SeoKeon/Robot-Control-Lab/README.md

# Robot Control Lab 🤖

> 펌웨어 엔지니어의 제어 실험 기록.
> 모터 관절 하나 → FOC 직접 구현 → 2축 로봇팔 + 보행 시뮬레이션.

실험 하나 끝날 때마다 [log/](log/)에 글 하나. 코드와 데이터는 [projects/](projects/)에.
실패한 튜닝, 태워먹은 부품까지 전부 기록한다.

## 타임라인

<!-- 최신이 위. 글을 올릴 때마다 여기에 한 줄 추가 -->

### 2026-10

- **10-10** 위치 루프 — 전류·속도·위치 캐스케이드 완성. +450도 갔다 돌아와도 0.2도 이내, 손으로 42도 밀었다 놓아도 0.4초에 복귀. 궤적 + 피드포워드, 정지 직전 끈적임(stick-slip) 관찰 ([log](log/2026-10-10-position-loop.md))
- **10-10** 속도 루프 — p1 완료 🎉 눌러도 150 rpm 을 지키고, 꽉 잡으면 iq 150 mA 한계에서 버티다 놓으면 0.2초에 복귀. J·Kt 로 게인 계산, 대역폭 5→15 Hz 로 한 바퀴 출렁임 sd 52 → 5 rpm. 블로킹 로그가 루프를 멈추던 결함도 발견 ([log](log/2026-10-10-speed-loop.md))
- **10-10** 전류 루프 — FOC 완성 🎉 꽉 잡아도 iq 가 지령 100.0 mA 에 고정 (전압 모드는 159 mA). 피드포워드 + 적분기 ([log](log/2026-10-10-current-loop-foc.md))
- **10-10** dq 전류 관측 — 정지 시 id≈0·iq 159mA 로 변환 검증, 회전 시 id 는 각도 지연 탓. AS5600 필터 + 각도 외삽 보정으로 무부하 id 45 → 2~4 mA ([log](log/2026-10-10-dq-observation-and-encoder-lag.md))
- **10-10** 전류 센싱 브링업 — 내장 OPAMP ×16 + ADC, 꼭대기 샘플링 정렬. 정지 벡터에서 +234/−103/−132 mA, 세 상 합 ≈ 0 ([log](log/2026-10-10-current-sense-bringup.md))
- **10-10** 첫 클로즈드루프 🎉 — 오프셋 캘리브레이션(−72.5°, 2회 차이 0.0°) + 엔코더 기반 정류. 정/역 255/−251 rpm, 잡았다 놓아도 0.5초 안에 복귀(탈조 없음) ([log](log/2026-10-10-first-closed-loop-commutation.md))
- **10-10** 지그 장착 + 엔코더 검증 — 드리프트 −44° → ±1°, 2회 재현, 회전 중 AGC 고정(PWM 간섭 없음) ([log](log/2026-10-10-jig-and-encoder-validation.md))

### 2026-08

- **08-29** AS5600 엔코더 브링업 — I2C 검증, 자석 부재→장착, 드리프트 원인 판별 실험 설계 ([log](log/2026-08-29-encoder-bringup.md))
- **08-27** 모터 첫 회전 🎉 — 오픈루프 왕복 스윕, 5단계 속도 추종·탈조 없음 (전류 0.2A 미만) ([log](log/2026-08-27-first-motor-rotation.md))
- **08-27** p0 완료 — 시리얼 "hello" 뚫기. UM2516 에서 핀맵 확정, USART2(PB3/PB4) VCP 확인 ([log](log/2026-08-27-p0-complete-uart-hello.md))
- **08-19** 보드 공용 계층 분리 — 실험마다 복제되던 HAL/CMSIS 를 platform/g431-esc1 한 벌로, 빌드 경로 정리 ([log](log/2026-08-19-platform-layer-and-build-setup.md))
- **08-05** B-G431B-ESC1 개발환경 세팅 — CubeCLT + VS Code로 빌드·플래싱·디버깅 완주 ([log](log/2026-08-05-dev-environment-setup.md))
- **08-01** 도착 부품 테스트 — 전원공급장치 C.V/C.C/OCP, 멀티미터 전류 측정에서 단락 ([log](log/2026-08-01-parts-testing.md))

### 2026-07

- **07-22** 프로젝트 시작 — 레포 개설, 목표 선언 ([log](log/2026-07-22-kickoff.md))

## 레포 구조

```
platform/g431-esc1/   보드 공용 계층 — 실험마다 동일한 것은 전부 여기 한 벌만
├── g431-esc1.ioc         CubeMX 프로젝트 (보드 단위 하나)
├── Core/, Drivers/       CubeMX 생성물 (HAL·CMSIS 포함)
├── bsp/                  손으로 쓴 보드 공용 코드 (핀 래퍼 등)
├── platform.cmake        프로젝트가 부르는 add_lab_firmware()
└── template/             새 실험 시작용 복사본

hardware/             기구 공용 계층 — 실험이 같이 쓰는 거치대·지그 (CadQuery 원본 + 출력 3MF)
└── foc-test-stand/       모터 + AS5600 + ESC1 테스트 거치대

projects/pN-이름/      실험 하나 = 폴더 하나
├── src/                  실험 코드 + 짧은 CMakeLists (platform 참조)
├── data/                 측정 데이터 (선별해서 커밋)
└── docs/                 회로도, 배선 사진 등

log/                  실험 하나 = 글 하나
notes/                이론 학습 노트
```

보드는 항상 B-G431B-ESC1 하나다. 그래서 HAL·CMSIS·startup·링커스크립트는
실험마다 복사하지 않고 `platform/g431-esc1` 한 벌을 공유한다.
새 실험은 `platform/g431-esc1/template/` 를 복사해서 시작한다 —
CubeMX를 새로 돌리지 않는다.

## 기록 규칙

1. **단위**: 실험(또는 공부 주제) 하나 = 글 하나. 몰아서 쓰지 않는다.
2. **위치와 이름**: `log/YYYY-MM-DD-제목.md` (예: `log/2026-08-02-closed-loop-position.md`).
   이미지·그래프는 `log/img/`에 넣고 글에서 상대경로로 링크.
3. **형식**: [log/_template.md](log/_template.md) 복사해서 시작.
   "뭘 하려고 했나 → 뭘 했나 → 막힌 것과 해결 → 배운 것" 순서. 막힌 과정이 본편.
4. **타임라인 갱신**: 글을 올리면 이 README 타임라인에 한 줄 추가 (최신이 위).
5. **코드·데이터**: `projects/` 아래 해당 프로젝트 폴더에 커밋하고 글에서 링크.
   데이터는 선별해서 커밋 (원시 로그 전체 X, 그래프 재현에 필요한 것만).
   보드 공용 코드는 `projects/` 가 아니라 `platform/g431-esc1/bsp/` 로 간다.
6. **실패도 기록**: 안 된 튜닝, 태워먹은 부품, 잘못 짚은 원인 전부.
   포트폴리오는 성공담이 아니라 문제 해결 서사다.
7. **커밋 메시지**: `log: 2026-08-02 클로즈드루프 위치 제어` / `p1: 엔코더 캘리브레이션 코드` 식으로
   접두어(log/p1/p2/…/notes/platform)를 붙인다.
8. **"되게 했다"에서 멈추지 않는다**: 왜 되는지 설명이 붙어야 글 완성.

## 장비 (계속 추가)

<!-- 새 장비 들어올 때마다 한 줄 추가 -->

| 장비 | 용도 | 추가 |
|---|---|---|
| B-G431B-ESC1 | 모터 드라이버 보드 (STM32G431, 3션트 전류 센싱) | 2026-07 |
| 짐벌모터 2804 (AS5600 내장) | 실험용 관절 | 2026-07 |
