SeoKeon/Robot-Control-Lab/notes/2026-07-22-pid-cascade-structure.md

# 2026-07-22 PID 캐스케이드 구조 — 전류→속도→위치

<!-- 예시 노트. 실습에서 막힌 지점을 이론에서 찾아올 때 이 형식으로 -->

## 왜 찾아봤나

SimpleFOC 설정에 전류/속도/위치 루프가 따로 있는 이유가 궁금해서.

## 핵심

- 모터 제어는 루프 3개가 겹겹이 싸인 구조: 가장 안쪽 **전류(=토크)** → **속도** → 가장 바깥 **위치**
- 안쪽 루프일수록 빨라야 한다 (전류 10~20kHz, 속도 ~1kHz, 위치 수백 Hz).
  바깥 루프 입장에서 안쪽 루프는 "즉시 반응하는 액추에이터"로 보여야 하기 때문
- **내부 루프 대역폭이 외부 루프 성능의 상한을 정한다** — 전류 루프가 느리면
  위치 게인을 아무리 올려도 소용없고 오히려 발진

## 실습 연결

- P1에서 클로즈드루프 전환 시 루프별 튜닝 순서: 안쪽부터 (전류 → 속도 → 위치)
- P3에서 사인 스윕으로 루프별 대역폭 실측해 이 관계 확인 예정

## 출처

- Brian Douglas, "Understanding PID Control" 시리즈
- SimpleFOC docs — motion control 페이지
