SeoKeon/Robot-Control-Lab/log/2026-07-22-kickoff.md

# 2026-07-22 프로젝트 시작 — 레포 개설, 목표 선언

## 뭘 하려고 했나

제어이론을 코어 역량으로 만들기 위한 실험 기록 레포 개설.
모터 관절 하나에서 시작해 FOC 직접 구현 → 2축 로봇팔 → 보행 시뮬레이션까지 간다.

## 뭘 했나

- GitHub 레포 생성, 폴더 구조·기록 규칙 확정
- 첫 실험 대상 확정: B-G431B-ESC1 + 짐벌모터 2804(AS5600)
- 다음 단계: 환경 구축 (마운트 고정, 배선, 개발환경, Blink + 시리얼 확인)

## 막힌 것과 해결 과정

없음 (셋업 단계)

## 배운 것 / 다음 할 것

- [ ] 어댑터 → XT30 변환 케이블 납땜
- [ ] 모터 마운트 고정 + 배선
- [ ] PlatformIO 설치, G431 인식 확인
