SeoKeon/Robot-Control-Lab/files/asm.png

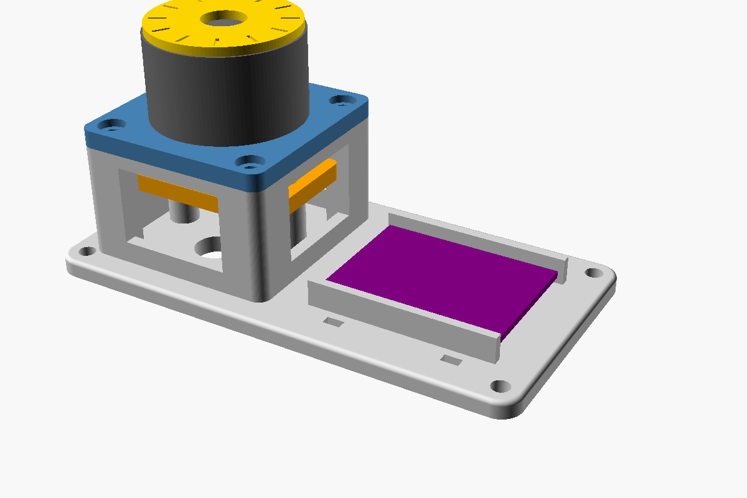
files/asm.png
