SeoKeon/Robot-Control-Lab/log/2026-08-01-parts-testing.md

# 2026-08-01 도착 부품 테스트 — 전원공급장치와 멀티미터

## 뭘 하려고 했나

도착한 부품이 정상인지 확인하고, 앞으로 계속 쓸 전원공급장치와 멀티미터의
사용법을 익히는 것. 모터를 물리기 전에 계측 장비부터 손에 익혀두려고 했다.

## 뭘 했나

1. 브레드보드에 전원공급장치 5V 2A 세팅
2. 집에 있는 간단한 쿨러를 연결하여 동작 확인 함
3. 5V → 7V로 올려서 회전수가 빨라지는지 확인
4. 멀티미터로 확인했을 때 최대측정 0.2A, 200mA로 설정했을 때 40mA 측정 됨.
   5V, 7V 모두 비슷하게 나왔음
5. 전압 출력은 **병렬**로 회로와 회로 끝을 확인하여 전원공급장치가 정상적으로
   전압을 주는 것을 확인
6. 전류는 위(4.)에 설명대로 **직렬**로 연결 후 측정 진행함

## 막힌 것과 해결 과정

### 저항 없는 회로에 멀티미터 전류를 물려 단락

이번 테스트 진행 중 실수로 저항이 없는 회로에 멀티미터 전류를 측정 했음.
이때 전류 한계는 0.2A로 지정. 저항이 없으므로 전류가 폭주하여 OCP 경고가 뜨며
전원공급장치에서 볼테이지 에러가 뜨며 전압공급이 중단 됨.

왜 이렇게 되는지가 핵심이었다.

- 멀티미터의 **전압** 측정은 내부저항이 매우 높아 멀티미터쪽으로 오는 전류가 최소화 됨.
  따라서 기존 회로에 영향을 최대한 주지 않을수록 좋은 멀티미터라고 함
- 멀티미터의 **전류** 측정의 경우 회로에 영향을 최대한 안 끼치기 위해 저항이 0임.
  `I = V/R` 이기 때문에 저항이 없는 회로를 측정하면 전류가 확 튈 수 있음

즉 전류 모드 멀티미터를 저항 없는 경로에 물리는 것은 그 자체가 단락이다.
이때 전원공급장치의 전류 공급 한계(limit)를 걸어놔야 그나마 안전함.

**해결/대처**: 전류 리밋이 0.2A로 걸려 있어서 OCP가 동작해 전압이 차단됐다.
리밋을 걸어두지 않았다면 부품이나 멀티미터 퓨즈가 갔을 상황.

## 배운 것 / 다음 할 것

### 전원공급장치의 세 가지 상태

전원 공급장치에는 C.V, C.C, OCP 라는 용어가 있었음.

이름 그대로 **무엇을 일정하게 유지하는가**가 차이다.

| 용어 | 뜻 |
|---|---|
| **C.V** (Constant Voltage) | 확인해보니 **전압을 일정하게 유지**하는 것을 의미함. 회로가 요구하는 전류가 리밋 안쪽일 때의 정상 상태 |
| **C.C** (Constant Current) | 확인해보니 **전류를 일정하게 유지**하는 것을 의미함. 저항이 너무 낮아서 전류가 확 튈 때 **전압을 그만큼 낮추어 전류를 고정**해줄 수 있다는 장점이 있음. 이를 활용하여 어디서 회로가 잘못됐는지 디버깅하는 데에 활용할 수 있음 |
| **OCP** (Over Current Protection) | 전류 한계보다 더 높은 전류를 요구하게 되었을 때 **전압을 차단**함 |

> 이해가 두 번 바뀐 항목이다.
> C.C 를 처음엔 "보낼 수 있는 전류 한계에 도달한 **상태**"로만 이해했는데,
> 다시 확인해보니 전압을 낮춰 전류 리밋을 유지하는 **기능**이었고,
> 한 번 더 확인해보니 결국 **전류를 일정하게 유지하는 것**이 본질이었다.
> (Gemini 설명: 전원을 끄지 않고 전압을 0V 근처로 떨어뜨리면서 안전한 전류만 계속 흘려준다)

### 단락을 찾을 때는 OCP 보다 C.C

AI한테 물어보니 실제 회로 단락 문제를 찾을 때는 OCP를 켜놓는 것 보단
**C.C 한계를 활용**하여 찾는게 더 수월하다고 함.
이유는 전원이 바로 차단되어버리면 디버깅이 어렵기 때문이라고 함.

C.C 로 두면 전류가 안전한 값으로 계속 흐르는 상태가 유지되므로,
그 상태에서 어디가 뜨거워지는지 / 어느 지점에서 전압이 떨어지는지를 짚어갈 수 있다.

### 다음

- 멀티미터 전류 모드는 **직렬 + 부하 있는 경로에만**. 물리기 전에 리밋 먼저 확인
- 모터를 물릴 때는 기동 전류(정지 상태에서 확 튀는 전류)를 감안해 리밋을 잡아야 함
