SeoKeon/Robot-Control-Lab/files/assembly.step

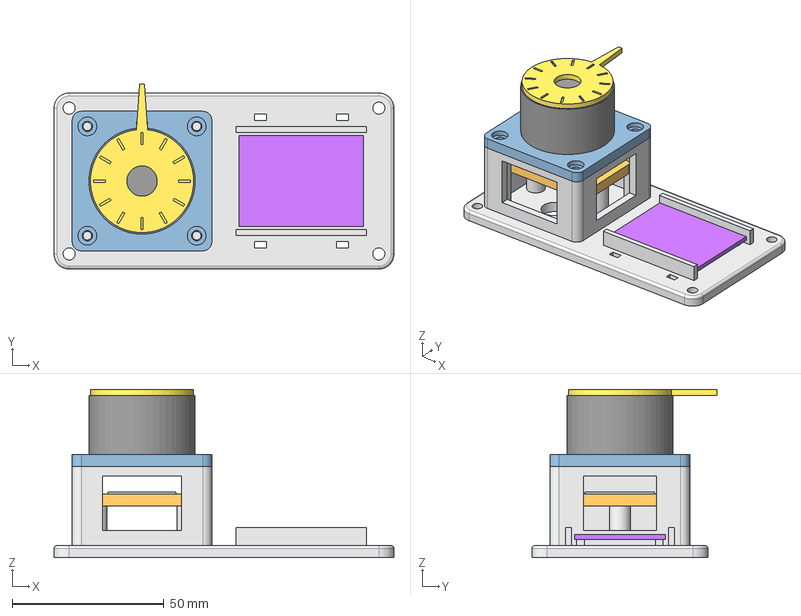
[picture p2: CAD file, 2026-10-10]
files/assembly.step
112.0 x 61.0 x 55.5 mm
base
motor_plate
sensor_carrier
as5600_dummy
motor_dummy
indicator
esc1_dummy
