SeoKeon/Robot-Control-Lab/files/out/assembly.step

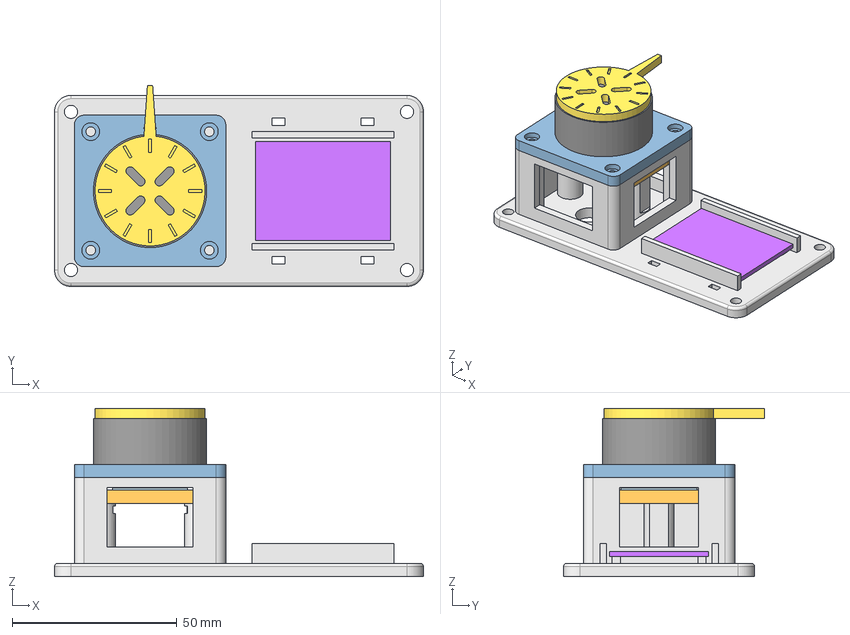
[picture p3: CAD file, 2026-10-10]
files/out/assembly.step
112.0 x 61.0 x 51.0 mm
base
motor_plate
sensor_carrier
as5600_dummy
motor_dummy
indicator
magnet_plug
esc1_dummy
