SeoKeon/Robot-Control-Lab/files/foc_test_stand_A1mini_v4.3mf

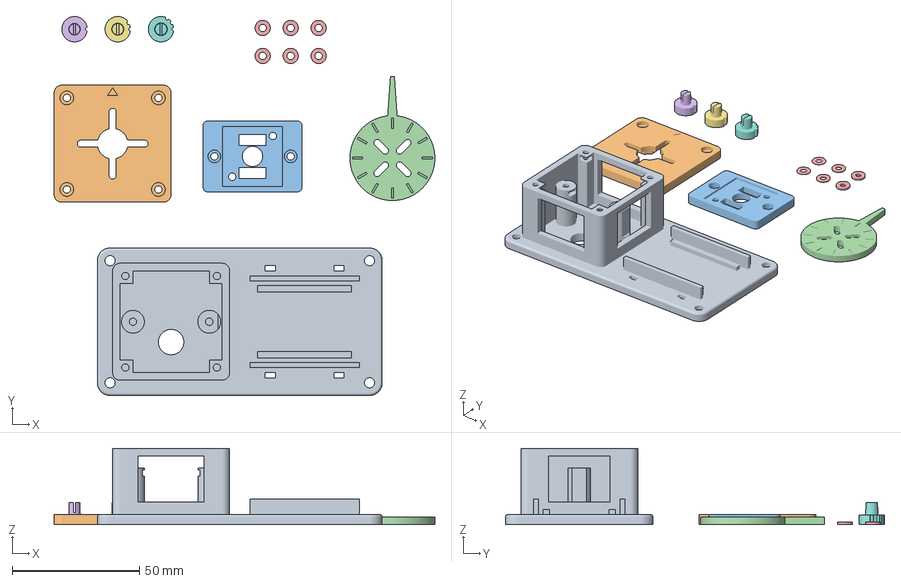
[picture p4: CAD file, 2026-10-10]
files/foc_test_stand_A1mini_v4.3mf
149.7 x 149.0 x 30.0 mm
base
motor_plate
sensor_carrier
indicator
spacers
magnet_plug_m4_4.5
magnet_plug_m4_4.7
magnet_plug_m4_4.9
