SeoKeon/Robot-Control-Lab/files/out/magnet_plug_m4_4.9.step

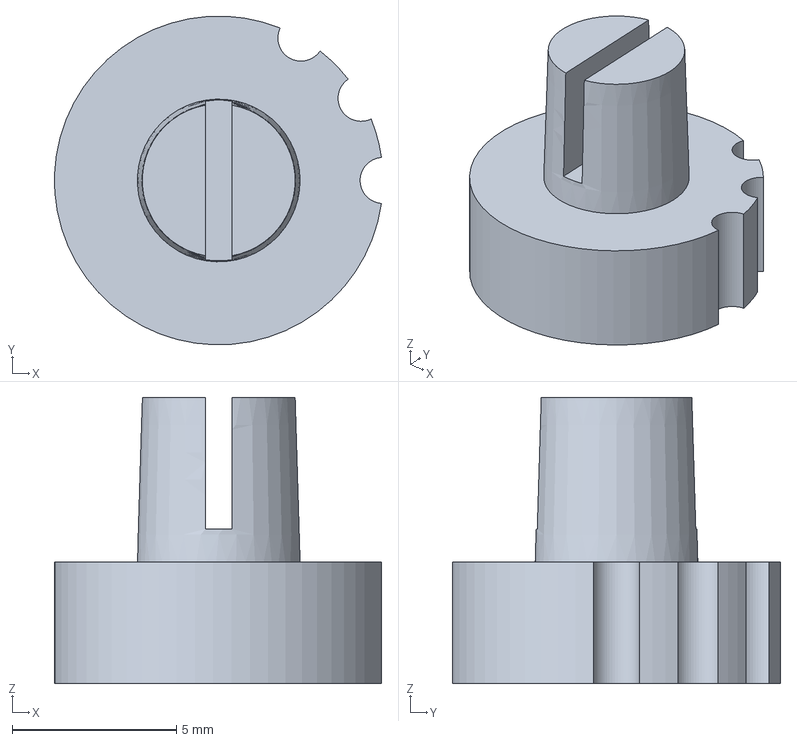
[picture p5: CAD file, 2026-10-10]
files/out/magnet_plug_m4_4.9.step
9.95 x 9.99 x 8.70 mm
