SeoKeon/Robot-Control-Lab/hardware/foc-test-stand/print/foc_test_stand_A1mini_v4_표시판.3mf

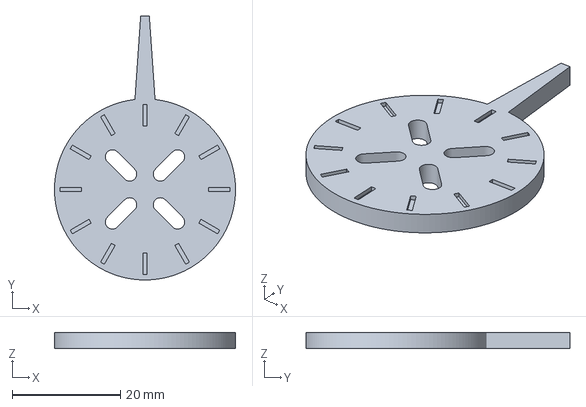
[picture p6: CAD file, 2026-10-10]
hardware/foc-test-stand/print/foc_test_stand_A1mini_v4_표시판.3mf
33.4 x 48.7 x 3.00 mm
