SeoKeon/Robot-Control-Lab/files/foc_test_stand_A1mini_v4_자석플러그.3mf

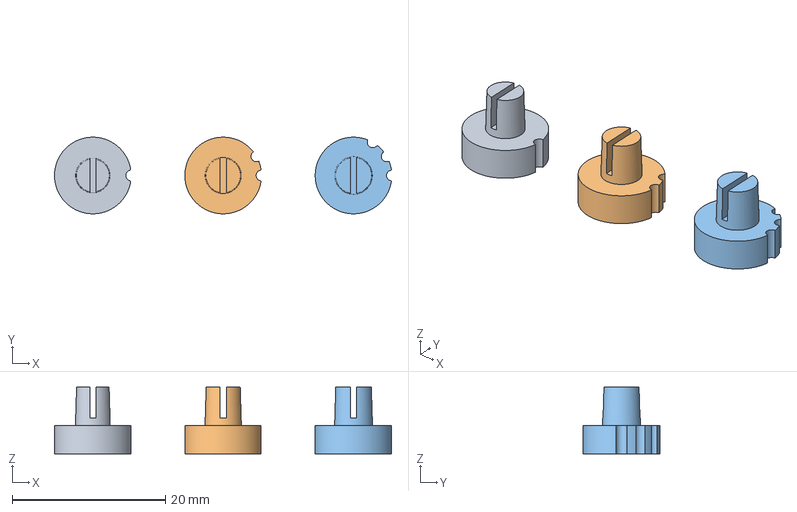
[picture p8: CAD file, 2026-10-10]
files/foc_test_stand_A1mini_v4_자석플러그.3mf
43.9 x 10.00 x 8.70 mm
magnet_plug_m4_4.5
magnet_plug_m4_4.7
magnet_plug_m4_4.9
