SeoKeon/Robot-Control-Lab/files/out/base.step

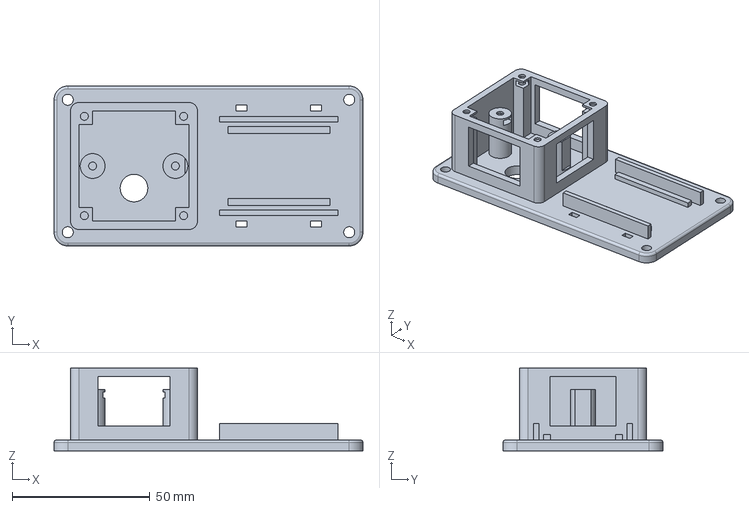
[picture p9: CAD file, 2026-10-10]
files/out/base.step
112.0 x 58.0 x 30.0 mm
