SeoKeon/Robot-Control-Lab/files/out/magnet_plug_m6_4.7.step

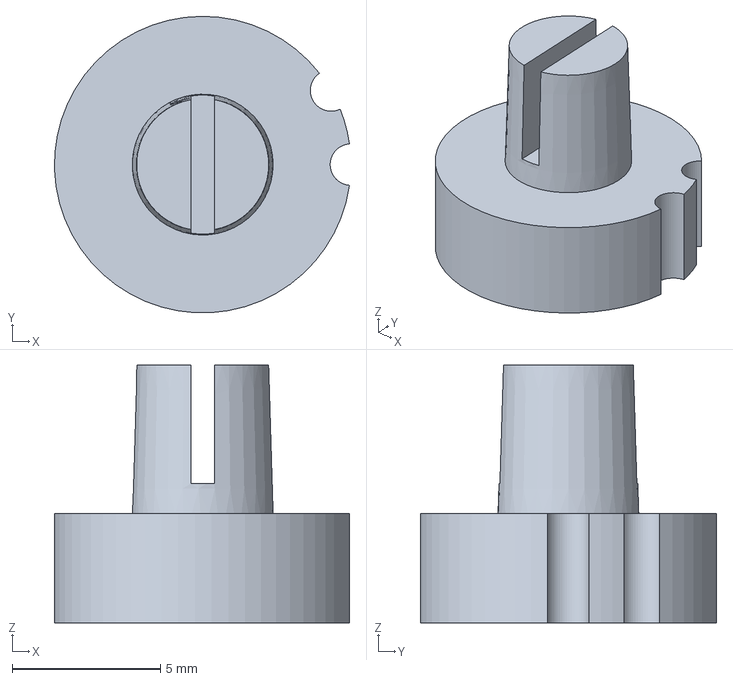
[picture p10: CAD file, 2026-10-10]
files/out/magnet_plug_m6_4.7.step
9.95 x 9.99 x 8.70 mm
