SeoKeon/Robot-Control-Lab/files/out/magnet_plug_m4_4.5.step

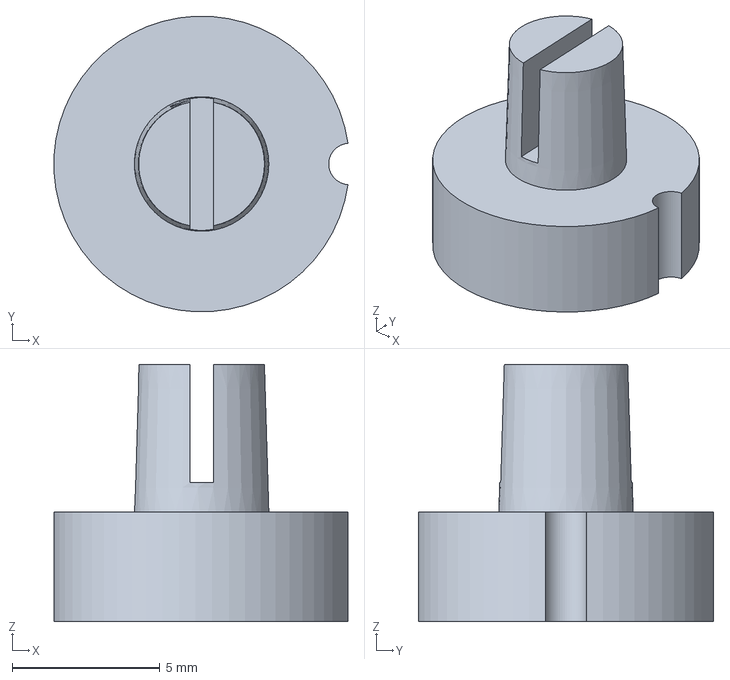
[picture p11: CAD file, 2026-10-10]
files/out/magnet_plug_m4_4.5.step
9.94 x 9.99 x 8.70 mm
