SeoKeon/Robot-Control-Lab/files/out/spacers.step

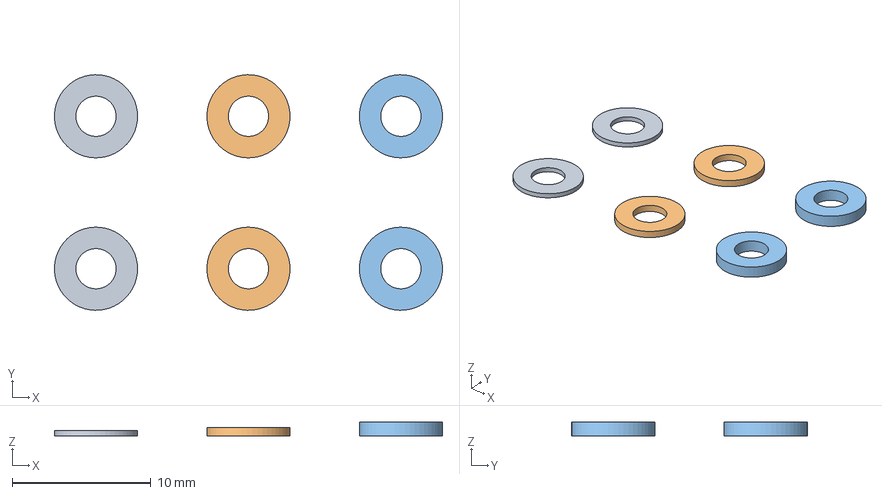
[picture p12: CAD file, 2026-10-10]
files/out/spacers.step
28.0 x 17.0 x 1.00 mm
