SeoKeon/Robot-Control-Lab/files/out/sensor_carrier.step

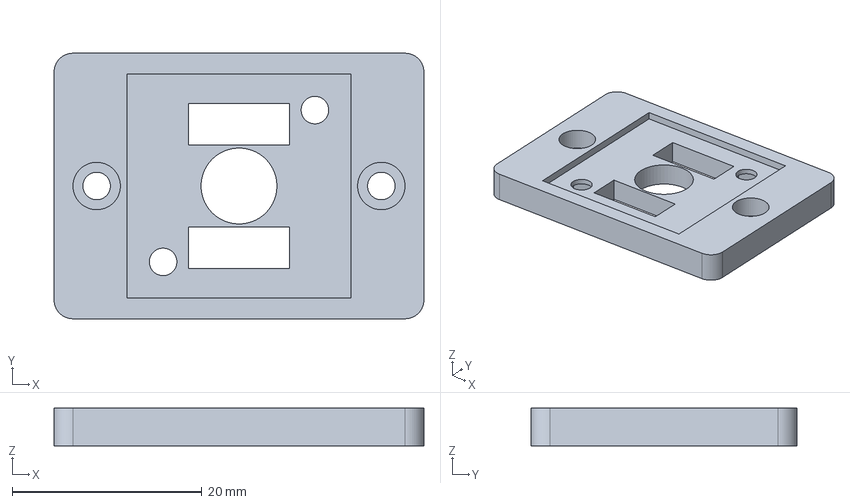
[picture p13: CAD file, 2026-10-10]
files/out/sensor_carrier.step
39.0 x 28.0 x 4.00 mm
