SeoKeon/Robot-Control-Lab/files/out/motor_plate.step

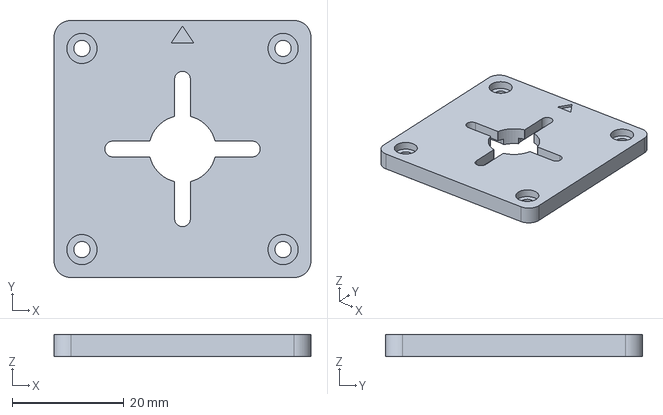
[picture p14: CAD file, 2026-10-10]
files/out/motor_plate.step
46.0 x 46.0 x 4.00 mm
