SeoKeon/Robot-Control-Lab/files/old/foc_test_stand_A1mini_v2.3mf

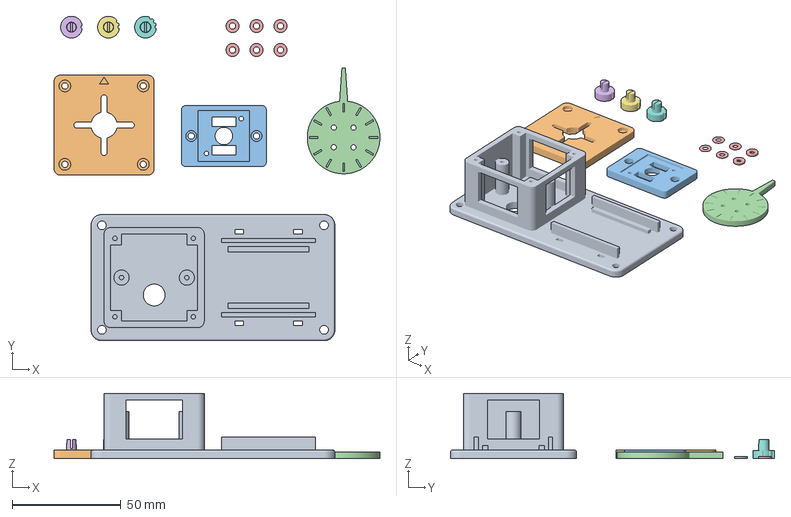
[picture p15: CAD file, 2026-10-10, an earlier design]
files/old/foc_test_stand_A1mini_v2.3mf
149.7 x 149.0 x 30.0 mm
base
motor_plate
sensor_carrier
indicator
spacers
magnet_plug_4.5
magnet_plug_4.7
magnet_plug_4.9
