SeoKeon/Robot-Control-Lab/(list of files, cad)

Other CAD files:
files/out/indicator.step
files/out/magnet_plug_m6_4.5.step
files/out/magnet_plug_m4_4.7.step
files/old/foc_test_stand_A1mini_v3.3mf
files/old/foc_test_stand_A1mini.3mf
files/old/foc_test_stand_A1mini_v3_재출력.3mf
files/out/base.stl
files/out/indicator.stl
files/out/magnet_plug_m4_4.5.stl
files/out/magnet_plug_m4_4.7.stl
files/out/magnet_plug_m4_4.9.stl
files/out/magnet_plug_m6_4.5.stl
files/out/magnet_plug_m6_4.7.stl
files/out/magnet_plug_m6_4.9.stl
files/out/motor_plate.stl
files/out/sensor_carrier.stl
files/out/spacers.stl
