SeoKeon/Robot-Control-Lab/projects/p1-foc-bringup/README.md

# p1-foc-bringup — 모터 첫 회전과 FOC

**목표**: 2804 짐벌모터를 실제로 돌린다. 오픈루프 첫 회전 → 전류 센싱 →
클로즈드루프 FOC. 완료 기준은 **전류 루프가 닫힌 상태로 속도 지령을 따라가는 것**.

- `src/foc_bringup/` — 실험 코드
- `data/` — 측정 데이터 (전류 파형, 속도 응답 등)
- `docs/` — (핀맵은 [p0-setup/docs/pinmap.md](../p0-setup/docs/pinmap.md) 에 있다)

## 모터

| | |
|---|---|
| 모델 | 2804 짐벌모터 (AS5600 내장) |
| 슬롯/극 | 12N14P → **pole pairs = 7** |
| 전기각 | θe = 7 × θm. 전기 360° = 기계 51.43° |
| 상간 저항 | **21Ω** 실측 (U-V, V-W, W-U 동일) → Y결선 상저항 10.5Ω |
| 스펙 상저항 | 11.2Ω — 실측 10.5Ω 과 일치 (제조사 스펙 교차 검증) |
| 외형/무게 | Ø34 × 15mm, 41.5g. 최대 14.8V / 5A / 약 2180rpm |
| **장착 나사 (실측)** | **베이스 4×M2.5** (홀 원 지름 약 19.8 mm, 깊이 4 mm 이상), **로터 4×M2** (배치 원 약 12.8 mm). 웹 스펙(베이스 M2)과 달랐다 — "2804" 는 제조사마다 다르니 실측이 정본 |
| 중공축 | 내경 4.7 mm (실측, 축과 함께 회전), 바닥 돌출 0, 모터 높이 14 mm |
| 코깅 주기 | LCM(12,14) = 84 → 4.29° |

이론 정리는 [2026-08-20 로그](../../log/2026-08-20-motor-anatomy-and-board-bringup.md) 참고.

첫 회전 기록: [2026-08-27 로그](../../log/2026-08-27-first-motor-rotation.md) · 이론: [상보 PWM/데드타임](../../notes/2026-08-27-tim1-complementary-pwm-deadtime.md), [오픈루프와 FOC](../../notes/2026-08-27-openloop-vector-and-why-foc.md)

## 안전 — 매번 확인

| 항목 | 값 | 왜 |
|---|---|---|
| 전원 전류 리밋 | **0.8~1A** | 정상 최대 0.57A(12V/21Ω)보다 위, 션트-스루보다 훨씬 아래 |
| 시작 듀티 | **20~30%** | 10%는 토크가 약해 안 움직일 수 있다 |
| 부하 | 없음 | 무부하, 모터 고정만 |
| 정지 벡터 유지 | 1~2초 | DC 가 권선에 계속 흘러 열이 쌓인다 |

⚠️ **TIM1_BKIN 이 MCU 에 연결돼 있지 않다.** 하드웨어 과전류 차단 경로가 없으므로
**전원공급장치의 전류 리밋이 유일한 실질 보호장치다.**

⚠️ **게이트 드라이버 EN 핀이 없다.** 6개 PWM 만으로 제어되므로 소프트웨어로 출력을
끊는 수단이 없다. 리셋 직후 MOE off / 듀티 0 으로 시작할 것.

## TIM1 설정값 (계산 완료)

| 항목 | 값 | 근거 |
|---|---|---|
| U상 | `CH1` PA8 / `CH1N` PC13 | UM2516 Table 4 |
| V상 | `CH2` PA9 / `CH2N` PA12 | |
| W상 | `CH3` PA10 / `CH3N` PB15 | |
| 카운터 모드 | Center-aligned | FOC 표준. 전류 샘플링 타이밍이 여기 걸린다 |
| Prescaler | 0 | |
| ARR | **4249** | 170MHz ÷ (2 × 4250) = **20 kHz** (가청 주파수 위) |
| **데드타임 (DTG)** | **149** (0x95) | **= 1000 ns.** 아래 유도 참고 |

### 데드타임 유도

L6387E 데이터시트 Table 5 (AC operation, VCC=15V, TJ=25°C, 전부 Typ. 값):

| 파라미터 | 값 |
|---|---|
| `ton` 턴온 전파지연 | 110 ns |
| `toff` 턴오프 전파지연 | 105 ns |
| `tr` 상승시간 (CL=1nF) | 50 ns |
| `tf` 하강시간 | 30 ns |
| 출력 sink/source 전류 | 400 mA / 650 mA |

Figure 6/7 (Ton/Toff vs 온도) 축이 250 ns 까지 그려져 있다 — 온도에 따라 typ 보다 커진다.

**상단이 완전히 꺼진 뒤에 하단이 켜져야 한다:**

```
DT_min ≳ (toff_최대 + MOSFET 게이트 방전) − ton_최소
       ≈ (약 200 + 약 250) − 약 70
       ≈ 380 ns
```

MOSFET 게이트 방전은 STL180N6F7 의 Qg 를 driver sink 전류(400 mA)로 나눈 추정치다
(정확한 값은 STL180N6F7 데이터시트 필요).

**첫 브링업은 ×2 여유를 두고 1000 ns 로 잡는다.** 근거:
- `TIM1_BKIN` 이 MCU 에 연결돼 있지 않아 **하드웨어 과전류 차단이 없다** → 보수적으로
- 20 kHz 주기 50 µs 중 1 µs = **2%** 뿐이라 변조 성능 손실이 사실상 없다

### GPIO 출력 속도는 Low 로 (6개 전부)

`PC13` 은 CubeMX 에서 **`Low` 밖에 선택할 수 없다.** PC13/14/15 는 백업 도메인
(RTC/TAMP/WKUP) 쪽 핀이라 구동 능력이 제한된다. 버그가 아니다.

**문제되지 않는다.** 회로도에서 확인한 `L6387ED` 결선:

```
L6387ED (상마다 하나 — U9/U10/U11)
  1 LIN  ← MCU 연결 (로직 입력, 수 pF CMOS)
  2 HIN  ← MCU 연결
  5 LVG  → MOSFET 게이트 (드라이버가 sink 400mA / source 650mA 로 구동)
  7 HVG  → MOSFET 게이트
```

MCU 는 MOSFET 게이트가 아니라 **드라이버의 로직 입력**만 흔든다. 부하가 수 pF 이므로
Low 속도로도 에지는 수 ns 다. 데드타임 예산은 드라이버 전파지연(105/110 ns)과
MOSFET 게이트 충·방전이 지배하고, MCU 슬루율은 그 안에서 무시할 수준이다.

→ **6개 핀 전부 Low 로 통일한다.** 절대 속도보다 **채널 간 편차(skew)** 가
중요하고, PC13 이 Low 고정이니 나머지도 맞추면 U/V/W 가 동일 조건이 된다.

> PC13 은 `TIM1_BKIN` 도 지원하는 핀이지만 여기선 CH1N 으로 쓴다.
> 어차피 보드에 BKIN 배선이 없어 무관하다.

### DTG 레지스터 환산 (RM0440, TIM1 BDTR)

TIM1 clk 170 MHz, CKD=1 → `t_DTS` = **5.882 ns**

| DTG[7:5] | 식 | 범위 |
|---|---|---|
| `0xx` | DT = DTG[7:0] × t_DTS | 0 ~ 747 ns |
| `100` | DT = (64 + DTG[5:0]) × 2 × t_DTS | 753 ~ 1118 ns |

1000 ns 는 첫 범위를 넘으므로 `100` 인코딩을 쓴다:

```
(64 + 21) × 2 × 5.882 ns = 85 × 11.765 = 1000.0 ns
DTG = 0b100_10101 = 0x95 = 149
```

> 대안: `DTG = 127` (0x7F) → 747 ns. 최소값(380 ns)의 약 2배로 이것도 방어 가능하다.
> 스코프로 상·하단 게이트 파형을 실측한 뒤 줄이는 게 정석이다.

## 진행 단계

- [x] TIM1 상보 PWM 6채널 + 데드타임 (2026-08-27)
- [x] (a) 정지 벡터 — 12스텝 추종 확인. m=0.30 은 토크 부족(94도 기대에 70도),
      PWM off 시 코깅 디텐트(4.29도)로 안착하는 것도 관찰
- [x] (b)(c) 왕복 스윕 — **모터 선이 함께 도는 구조라 기계각 180도 제한** →
      연속 회전 대신 ±50도 왕복으로 변경. m=0.45, 5단계 속도 전부 추종,
      전류 0.2A 미만, 탈조 없음. **오픈루프 한계는 기계 457deg/s(76rpm) 이상**
- [x] ADC + 내장 OPAMP 3션트 전류 센싱 (2026-10-10) — PGA ×16, 꼭대기 샘플링, 1 count ≈ 29.4 mA.
      정지 벡터에서 세 상 패턴·부호·합≈0 확인. [로그](../../log/2026-10-10-current-sense-bringup.md)
- [x] Clarke/Park dq 관측 (2026-10-10) — 정지 시 id≈0, iq 159mA. 회전 시 id 는 각도 지연 탓,
      AS5600 필터 SF=2x 로 1.68→0.85ms. [로그](../../log/2026-10-10-dq-observation-and-encoder-lag.md)
- [x] 각도 외삽(θ + ω·τ) — τ 스윕으로 id=0 지점 0.87ms 확인, τ=0.85ms 고정. 무부하 id 45 → 2~4 mA
- [x] 전류 루프 (2026-10-10) — 피드포워드(R·iq + ψ·ω) + 적분기. 정지 시 iq 100.0 mA = 지령, id 0.0.
      [로그](../../log/2026-10-10-current-loop-foc.md)
- [x] d축 우선 전압 제한 (2026-10-10) — 계단 직후 포화(최대 10%) 중에도 id ±1 mA
- [x] 속도 루프 (2026-10-10) ← **p1 완료 기준 달성**. 속도 PI → iq 지령(±150 mA), 게인은
      J·Kt 에서 계산, 대역폭 15 Hz. 평균 오차 0.1 rpm 이내, 꽉 잡으면 iq 150.0 mA 한계 고정,
      놓으면 0.2 s 복귀. [로그](../../log/2026-10-10-speed-loop.md)
- [x] UART 비동기 송신 — 블로킹 로그가 100 ms 마다 루프를 6 ms 멈추던 결함 수정
- [x] 위치 루프 (2026-10-10, 완료 기준 너머) — 위치 P(4 Hz) + 사다리꼴 궤적 + 속도·가속 피드포워드.
      +450도 갔다 복귀해도 0.2도 이내, 밀면 iq 한계까지 버티고 놓으면 0.3~0.4 s 에 ±2도.
      정지 직전 stick-slip 관찰. [로그](../../log/2026-10-10-position-loop.md)
- [x] AS5600 엔코더 (2026-10-10) — 지그(접착 자석 플러그 + 스페이서 1mm)로 MD=1 / AGC=21.
      오픈루프 통합 실험 2회: 부호판정 50.2/50.3도(기대 51.4), 최종 오차 −1.1/+0.7도,
      회전 중 AGC 24 고정(간섭 없음). 08-29 드리프트(−44/−21.6도) 해소.
      [로그](../../log/2026-10-10-jig-and-encoder-validation.md) · 원본 데이터는 `data/`
- [x] 전기각 오프셋 캘리브레이션 → 엔코더 기반 정류 = 전압 모드 FOC (2026-10-10).
      오프셋 −72.5도(2회 차이 0.0), 정/역 255/−251 rpm, 브레이크 후 0.5초 내 복귀,
      전류 0.13A(회전)→0.16A(부하). [로그](../../log/2026-10-10-first-closed-loop-commutation.md)

## 빌드

```powershell
cd src\foc_bringup
cmake --preset Debug
cmake --build --preset Debug
```
