SeoKeon/Robot-Control-Lab/log/2026-08-20-motor-anatomy-and-board-bringup.md

# 2026-08-20 실습 준비 및 간단한 이론공부 진행

## 뭘 하려고 했나

- 모터를 보드에 연결하여 직접 돌려보려고 했으나, 필요물품이 부족한것을 알고 저항측정 및 준비만 추가로 진행

## 뭘 했나
- 엔코더에 선 연결용 납땜이 되지않아 이 부분 진행
- XT30 사용방법 숙지
- g431-esc1 보드 +- 확인방법 숙지
- 2804 짐벌모터 저항 UVW 측정 아무곳이나 찍었을때
12 : 21옴
13 : 21옴
23 : 21옴

## 막힌 것과 해결 과정
- 330°C인데 납이 패드에 안 붙고 인두팁에만 붙음
  → 팁 산화 / 팁에서 납을 먼저 녹인 순서 / 플럭스 부족
  → 팁 청소 후 즉시 코팅, 패드를 먼저 데우고 납은 패드 쪽에 댈 것
- 케이블이 아두이노 점퍼선(AWG24~28)뿐 → 내열·강도 부족, AWG20 실리콘 와이어 주문

## 배운 것 / 다음 할 것
- g431 보드에 5핀 커넥터의 테두리와 전압 공급용 부위는 같은 그라운드이므로 납땜전 햇갈릴때 확인 가능
- XT30 연결 및 바나나커넥터 납땜 후 전압 공급기에 연결하여 g431 보드에 전원인가
- g431보드 UVW 3상을 2804모터에 연결 및 납땜
- 저항측정을 기반으로 흘려야하는 전류를 확인하여 초기 전압 확인 및 모터 회전 확인
- XT30: 전원 나오는 쪽(케이블)=암, 받는 쪽(보드)=수

## 이해한 것
- 전기각 = 자속 파형의 위상. θe = 7 × θm
- 자석 N-S 한 쌍 = 자속 루프 하나 = 전기각 360° = 기계각 51.43°
- 12N14P: 이빨 2개씩 6그룹, 한 상이 4코일. 쌍 안에서 권선 방향 반전(210°→30°)
- 각 상 유효축이 전기각 120° 간격 → 합성 벡터 1.5I가 회전
- SimpleFOC pole_pairs에는 7을 넣을 것 (14 아님)

## 간단한 이론 공부 (공부 후 Claude 요약)
1. 모터의 물리 구조
스테이터 — 규소강판을 겹친 철심. 안쪽(아웃러너는 바깥쪽)으로 돌기가 나 있고 이게 이빨(tooth). 이빨에 코일을 감고, 이빨 사이 골이 슬롯. 이빨과 슬롯은 개수가 같다.
로터 — 영구자석이 원주를 따라 N, S 교대로 붙어 있음. 자석 하나가 1극(Pole), N-S 한 쌍이 1극쌍(Pole pair).
12N14P 표기 — N은 슬롯 수, P는 극 수. 2804는 슬롯 12, 자석 14 = 7극쌍.

2. 극의 방향
자석은 반경 방향으로 자화되어 있다. 자석 하나의 N과 S는 안쪽 면과 바깥쪽 면으로 마주본다.
원주를 따라 보이는 N, S, N, S는 서로 다른 자석의 안쪽 면이다. 하나 걸러 뒤집어 붙였을 뿐.
자속은 이웃한 N과 S를 잇는 폐루프를 그린다 — 180° 맞은편이 아니라 바로 옆으로 돌아온다. 이 루프 하나가 자기 회로의 최소 반복 단위.

3. 전기각 = 자속 파형의 위상
스테이터에 고정된 한 점에서 자속을 측정하면, 로터 1회전당 사인파 7주기가 지나간다. 자석 14개가 차례로 지나가니까.
전기각은 이 파형의 위상이고, **한 주기 = 360°**로 정의한다.
θe = 극쌍수 × θm = 7 × θm
전기각 360°  ↔  기계각 51.43°
"전기 한 바퀴 = 자석 한 쌍"은 정의가 아니라 결과. 자석 한 쌍만큼 이동하면 자기 상태가 완전히 동일해지고(모터는 그 이동을 구분 못 한다), 그게 한 주기의 정의니까.
감속기 비유로는 전기각이 입력축, 기계각이 7:1 출력축. 단 각도 환산 관계로만 유효하다.

4. 12N14P 권선 배치
이빨 12개가 인접 2개씩 6그룹. 한 상이 마주보는 두 그룹, 즉 코일 4개를 가져간다.
1  2   3  4   5  6   7  8   9 10  11 12
U  U   V  V   W  W   U' U'  V' V'  W' W'
왜 인접 쌍인가 — 이빨 간격 30° × 7 = 전기각 210°. 3상에 안 맞는다. 한쪽 코일을 거꾸로 감으면 210 − 180 = **30°**가 되어 두 코일이 합쳐진다.
검증 — 인접 그룹은 이빨 4개(기계각 120°) 간격, ×7 = 840 ≡ 전기각 120°. 3상 성립.
완전히 겹치지 않아 cos(15°)만큼 손해. 최종 권선계수 0.933.
프라임(') — 별개 상이 아니라 같은 상의 반대 극성 절반. 같은 전류가 흐르지만 반대로 감겨 자극이 뒤집힌다.

5. 회전자기장
개별 이빨은 회전하지 않는다. 제자리에서 N ↔ S를 왕복할 뿐. 전광판 글자가 흘러가는 것과 같은 원리로, 패턴이 미끄러지는 것이다.
각 상의 코일 4개를 합치면 하나의 유효 축이 되고, 세 축이 전기각 120° 간격으로 벌어진다(15°, 135°, 255°).
합성 벡터 = 1.5 × I, 크기 일정, 방향만 회전
어느 한 상이 0을 지나도 나머지 둘이 받쳐줘서 데드 포인트가 없다. 이게 3상을 쓰는 이유.
토크 조건 — 스테이터 자기장이 로터보다 전기각 90° 앞설 때 최대. τ ∝ sin(위상차). 겹치면(d축) 토크 0, 열만 남음. 90°가 q축.

6. 슬롯·극 조합 규칙
성립 조건 — N은 3의 배수, P는 짝수, N과 P가 나누어떨어지면 안 됨.
3N6P가 안 되는 이유: 120° × 3 = 360 ≡ 0°. 세 이빨 위상이 같아져 벡터가 회전하지 못하고 크기만 변한다. 3N2P, 3N4P는 성립.
코깅 — 무전원 상태에서 자석이 철심에 끌리는 힘. 주기는 LCM(슬롯, 극)으로 결정. 12N14P는 LCM(12,14)=84 → **4.29°**로 잘게 쪼개져 아주 부드럽다.
코깅이 크다 ≠ 못 돈다. 두 문제는 별개.
슬롯 늘리기 = 부드러움, 극 늘리기 = 토크, 크기 늘리기 = 진짜 힘. 슬롯을 늘리면 구리 공간이 줄어 오히려 손해일 수 있다.

7. 실습으로 이어지는 것
pole_pairs = 7 (14 아님). 예제 기본값 11을 반드시 바꿀 것
Y결선 → 두 상선 사이 저항은 상저항의 2배. 21Ω 측정 → 상저항 10.5Ω
상선 순서는 무관. 두 가닥 바꾸면 회전 방향만 반대
initFOC()에서 모터가 덜컥 움직이는 것 = d축 전압으로 강제 정렬해 전기각 오프셋을 측정하는 과정. 이때 손으로 잡으면 안 됨
극쌍수 확인법 — 전기각 1회전 시 로터가 51.43° 이동하는지, 또는 상선에 스코프 물리고 손으로 한 바퀴 돌려 사인파 개수 세기
600 rpm → 전기 주파수 70 Hz (×7)
