SeoKeon/Robot-Control-Lab/hardware/foc-test-stand/img/asm_v2_section.png

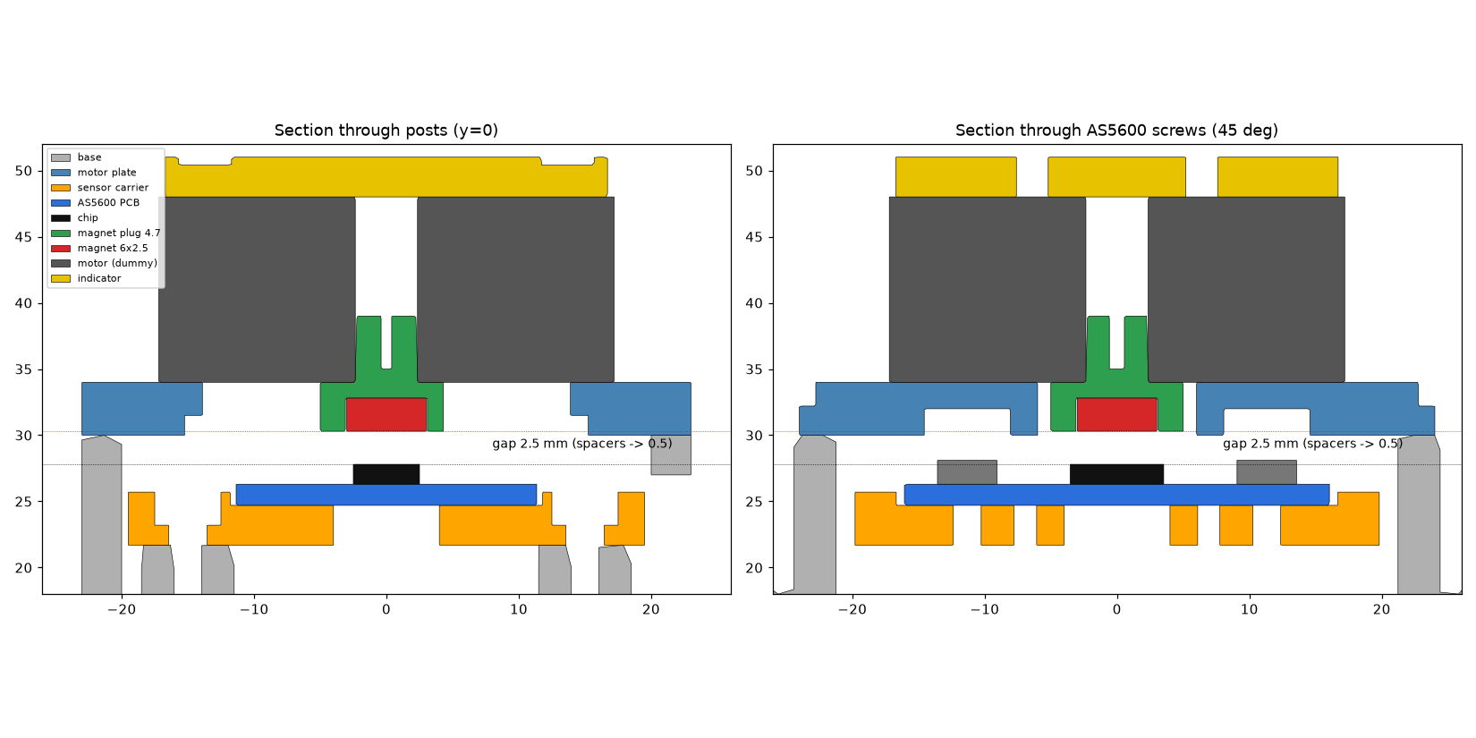
hardware/foc-test-stand/img/asm_v2_section.png
