SeoKeon/Robot-Control-Lab/platform/g431-esc1/g431-esc1.ioc

Mcu.UserName=STM32G431CBUx
PA1.Signal=OPAMP1_VINP
PA10.Signal=S_TIM1_CH3
PA12.Signal=TIM1_CH2N
PA13.Signal=SYS_JTMS-SWDIO
PA14.Signal=SYS_JTCK-SWCLK
PA3.Signal=OPAMP1_VINM0
PA5.Signal=OPAMP2_VINM0
PA7.Signal=OPAMP2_VINP
PA8.Signal=S_TIM1_CH1
PA9.Signal=S_TIM1_CH2
PB0.Signal=OPAMP3_VINP
PB15.Signal=TIM1_CH3N
PB2.Signal=OPAMP3_VINM0
PB3.Signal=USART2_TX
PB4.Signal=USART2_RX
PB7.Signal=I2C1_SDA
PB8-BOOT0.Signal=I2C1_SCL
PC13.Signal=TIM1_CH1N
PC6.GPIO_Label=LD2
PC6.Signal=GPIO_Output
