SeoKeon/Robot-Control-Lab/platform/g431-esc1/bsp/Src/bsp.c

#include "bsp.h"

#include <stdarg.h>
#include <stdio.h>
#include <string.h>
#include <math.h>

/* CubeMX 가 Core/Src/main.c 에 만든 핸들. MX_USART2_UART_Init() 이
   app_main() 보다 먼저 불리므로 여기서 바로 써도 된다. */
extern UART_HandleTypeDef huart2;

#define BSP_UART          (&huart2)
#define BSP_UART_TIMEOUT  100u   /* ms. 블로킹 송신이라 무한대기는 피한다 */

#define TXQ_SIZE 2048u   /* 2의 거듭제곱 */
static uint8_t           txq[TXQ_SIZE];
static volatile uint16_t txq_head, txq_tail;   /* head = 넣는 쪽(메인), tail = 빼는 쪽(인터럽트) */
static volatile int      txq_async;
static uint32_t          txq_dropped;

void USART2_IRQHandler(void)
{
    USART_TypeDef *u = BSP_UART->Instance;
    if ((u->CR1 & USART_CR1_TXEIE_TXFNFIE) && (u->ISR & USART_ISR_TXE_TXFNF)) {
        if (txq_tail != txq_head) {
            u->TDR = txq[txq_tail];
            txq_tail = (uint16_t)((txq_tail + 1u) & (TXQ_SIZE - 1u));
        } else {
            u->CR1 &= ~USART_CR1_TXEIE_TXFNFIE;
        }
    }
}

uint32_t bsp_uart_set_async(int on)
{
    if (on) {
        HAL_NVIC_SetPriority(USART2_IRQn, 3, 0);
        HAL_NVIC_EnableIRQ(USART2_IRQn);
        txq_async = 1;
    } else if (txq_async) {
        uint32_t t0 = HAL_GetTick();
        while (txq_tail != txq_head && HAL_GetTick() - t0 < 2000u) { }
        txq_async = 0;
    }
    return txq_dropped;
}

void bsp_uart_write(const uint8_t *data, uint16_t len)
{
    if (!txq_async) {
        HAL_UART_Transmit(BSP_UART, (uint8_t *)data, len, BSP_UART_TIMEOUT);
        return;
    }
    for (uint16_t i = 0; i < len; i++) {
        uint16_t next = (uint16_t)((txq_head + 1u) & (TXQ_SIZE - 1u));
        if (next == txq_tail) { txq_dropped += (uint32_t)(len - i); break; }
        txq[txq_head] = data[i];
        txq_head = next;
    }
    __disable_irq();
    BSP_UART->Instance->CR1 |= USART_CR1_TXEIE_TXFNFIE;
    __enable_irq();
}

void bsp_uart_puts(const char *s)
{
    bsp_uart_write((const uint8_t *)s, (uint16_t)strlen(s));
}

void bsp_printf(const char *fmt, ...)
{
    char    buf[256];
    va_list ap;

    va_start(ap, fmt);
    int n = vsnprintf(buf, sizeof buf, fmt, ap);
    va_end(ap);

    if (n <= 0) {
        return;
    }
    /* vsnprintf 는 "잘리지 않았다면 필요했을 길이"를 준다 */
    if (n > (int)sizeof buf - 1) {
        n = (int)sizeof buf - 1;
    }
    bsp_uart_write((const uint8_t *)buf, (uint16_t)n);
}

void bsp_led_on(void)     { HAL_GPIO_WritePin(BSP_LED_PORT, BSP_LED_PIN, GPIO_PIN_SET); }
void bsp_led_off(void)    { HAL_GPIO_WritePin(BSP_LED_PORT, BSP_LED_PIN, GPIO_PIN_RESET); }
void bsp_led_toggle(void) { HAL_GPIO_TogglePin(BSP_LED_PORT, BSP_LED_PIN); }

/* ===================== AS5600 (I2C1) ===================== */

extern I2C_HandleTypeDef hi2c1;   /* CubeMX 가 main.c 에 만든 핸들 */

#define AS5600_HAL_ADDR   (BSP_AS5600_ADDR << 1)   /* HAL 은 8비트 주소를 받는다 */
#define AS5600_REG_STATUS 0x0Bu
#define AS5600_REG_RAWANG 0x0Cu                    /* 0x0C(H) 0x0D(L) 빅엔디언 */
#define AS5600_I2C_TO     20u                      /* ms */

void bsp_i2c_scan(void)
{
    int found = 0;

    bsp_uart_puts("I2C1 scan:");
    for (uint8_t a = 0x08; a < 0x78; a++) {
        if (HAL_I2C_IsDeviceReady(&hi2c1, (uint16_t)(a << 1), 1, 5) == HAL_OK) {
            bsp_printf(" 0x%02X", a);
            found++;
        }
    }
    bsp_printf("  (%d개)\r\n", found);
}

int bsp_as5600_magnet_ok(uint8_t *detail)
{
    uint8_t st = 0;

    if (HAL_I2C_Mem_Read(&hi2c1, AS5600_HAL_ADDR, AS5600_REG_STATUS,
                         I2C_MEMADD_SIZE_8BIT, &st, 1, AS5600_I2C_TO) != HAL_OK) {
        if (detail) { *detail = 0; }
        return 0;
    }
    if (detail) { *detail = st; }
    return (st & 0x20u) ? 1 : 0;   /* bit5 MD */
}

int bsp_as5600_read_agc(uint8_t *agc)
{
    /* AGC(0x1A): 자동 게인. 5V 모드 0~255, 3.3V 모드 0~128.
       값이 클수록 자기장이 약하다 = 자석이 멀다. 중간값(약 64)이 이상적. */
    if (HAL_I2C_Mem_Read(&hi2c1, AS5600_HAL_ADDR, 0x1Au,
                         I2C_MEMADD_SIZE_8BIT, agc, 1, AS5600_I2C_TO) != HAL_OK) {
        return -1;
    }
    return 0;
}

int bsp_as5600_set_filter(uint8_t sf, uint8_t fth, uint16_t *conf_out)
{
    /* CONF: 0x07 = [WD | FTH(3) | SF(2)], 0x08 = [PWMF | OUTS | HYST | PM] */
    uint8_t hi = 0;
    if (HAL_I2C_Mem_Read(&hi2c1, AS5600_HAL_ADDR, 0x07u, I2C_MEMADD_SIZE_8BIT,
                         &hi, 1, AS5600_I2C_TO) != HAL_OK) { return -1; }
    hi = (uint8_t)((hi & ~0x1Fu) | ((fth & 0x07u) << 2) | (sf & 0x03u));
    if (HAL_I2C_Mem_Write(&hi2c1, AS5600_HAL_ADDR, 0x07u, I2C_MEMADD_SIZE_8BIT,
                          &hi, 1, AS5600_I2C_TO) != HAL_OK) { return -1; }
    if (conf_out) {
        uint8_t b[2] = {0, 0};
        HAL_I2C_Mem_Read(&hi2c1, AS5600_HAL_ADDR, 0x07u, I2C_MEMADD_SIZE_8BIT, b, 2, AS5600_I2C_TO);
        *conf_out = (uint16_t)(((uint16_t)b[0] << 8) | b[1]);
    }
    return 0;
}

int bsp_as5600_read_raw(uint16_t *raw)
{
    uint8_t b[2];

    if (HAL_I2C_Mem_Read(&hi2c1, AS5600_HAL_ADDR, AS5600_REG_RAWANG,
                         I2C_MEMADD_SIZE_8BIT, b, 2, AS5600_I2C_TO) != HAL_OK) {
        return -1;
    }
    *raw = (uint16_t)(((uint16_t)(b[0] & 0x0Fu) << 8) | b[1]);
    return 0;
}

/* ===================== 3상 PWM (TIM1) ===================== */

extern TIM_HandleTypeDef htim1;   /* CubeMX 가 main.c 에 만든 핸들 */

#define BSP_TIM (&htim1)

static float bsp_clampf(float v, float lo, float hi)
{
    return (v < lo) ? lo : ((v > hi) ? hi : v);
}

void bsp_pwm_start(void)
{
    /* 켜기 전에 듀티 0. 상보 PWM 이므로 이 상태는 하단 3개만 ON = 3상 단락(브레이크).
       회전자가 정지 상태라면 전류가 흐르지 않는다. */
    __HAL_TIM_SET_COMPARE(BSP_TIM, TIM_CHANNEL_1, 0);
    __HAL_TIM_SET_COMPARE(BSP_TIM, TIM_CHANNEL_2, 0);
    __HAL_TIM_SET_COMPARE(BSP_TIM, TIM_CHANNEL_3, 0);

    HAL_TIM_PWM_Start(BSP_TIM, TIM_CHANNEL_1);
    HAL_TIMEx_PWMN_Start(BSP_TIM, TIM_CHANNEL_1);
    HAL_TIM_PWM_Start(BSP_TIM, TIM_CHANNEL_2);
    HAL_TIMEx_PWMN_Start(BSP_TIM, TIM_CHANNEL_2);
    HAL_TIM_PWM_Start(BSP_TIM, TIM_CHANNEL_3);
    HAL_TIMEx_PWMN_Start(BSP_TIM, TIM_CHANNEL_3);
}

void bsp_pwm_stop(void)
{
    HAL_TIM_PWM_Stop(BSP_TIM, TIM_CHANNEL_1);
    HAL_TIMEx_PWMN_Stop(BSP_TIM, TIM_CHANNEL_1);
    HAL_TIM_PWM_Stop(BSP_TIM, TIM_CHANNEL_2);
    HAL_TIMEx_PWMN_Stop(BSP_TIM, TIM_CHANNEL_2);
    HAL_TIM_PWM_Stop(BSP_TIM, TIM_CHANNEL_3);
    HAL_TIMEx_PWMN_Stop(BSP_TIM, TIM_CHANNEL_3);

    /* 확실히 끊는다. OCIdleState=Reset 이므로 6핀 모두 Low = MOSFET 전부 off */
    __HAL_TIM_MOE_DISABLE(BSP_TIM);

    /* HAL 은 채널을 다 끄면 카운터까지 멈춘다. 카운터는 계속 돌려야 전류 센싱 ADC
       트리거가 끊기지 않고 꼭대기 정렬도 유지된다. MOE=0 이라 출력은 전부 off */
    __HAL_TIM_ENABLE(BSP_TIM);
}

void bsp_pwm_set_duty(float du, float dv, float dw)
{
    du = bsp_clampf(du, BSP_PWM_DUTY_MIN, BSP_PWM_DUTY_MAX);
    dv = bsp_clampf(dv, BSP_PWM_DUTY_MIN, BSP_PWM_DUTY_MAX);
    dw = bsp_clampf(dw, BSP_PWM_DUTY_MIN, BSP_PWM_DUTY_MAX);

    __HAL_TIM_SET_COMPARE(BSP_TIM, TIM_CHANNEL_1, (uint32_t)(du * (float)BSP_PWM_ARR));
    __HAL_TIM_SET_COMPARE(BSP_TIM, TIM_CHANNEL_2, (uint32_t)(dv * (float)BSP_PWM_ARR));
    __HAL_TIM_SET_COMPARE(BSP_TIM, TIM_CHANNEL_3, (uint32_t)(dw * (float)BSP_PWM_ARR));
}

void bsp_pwm_set_vector(float theta_e, float m)
{
    static const float k120 = 2.0943951f;   /* 2*pi/3 */

    const float amp = 0.5f * m;
    bsp_pwm_set_duty(0.5f + amp * cosf(theta_e),
                     0.5f + amp * cosf(theta_e - k120),
                     0.5f + amp * cosf(theta_e + k120));
}

/* ===================== 전류 센싱 (OPAMP + ADC injected) ===================== */

extern ADC_HandleTypeDef   hadc1, hadc2;
extern OPAMP_HandleTypeDef hopamp1, hopamp2, hopamp3;

int bsp_cs_trigger_point(uint32_t *cnt, uint32_t *dir_down)
{
    __HAL_ADC_CLEAR_FLAG(&hadc1, ADC_FLAG_JEOS);
    uint32_t t0 = HAL_GetTick();
    while (!__HAL_ADC_GET_FLAG(&hadc1, ADC_FLAG_JEOS)) {
        if (HAL_GetTick() - t0 > 5u) { return -1; }   /* 트리거가 안 온다 */
    }
    *cnt      = BSP_TIM->Instance->CNT;
    *dir_down = (BSP_TIM->Instance->CR1 & TIM_CR1_DIR) ? 1u : 0u;
    return 0;
}

/* 카운터를 멈추고 UG 로 다시 시작한다. UG 순간 반복 카운터에 실릴 값(rcr_at_ug)에
   따라 Update(=ADC 트리거)가 꼭대기에 올지 바닥에 올지가 갈린다. 이후 RCR=1. */
static void tim1_restart_with_rcr(uint32_t rcr_at_ug)
{
    TIM_TypeDef *t = BSP_TIM->Instance;
    t->CR1 &= ~TIM_CR1_CEN;
    t->RCR  = rcr_at_ug;
    t->EGR  = TIM_EGR_UG;          /* CNT=0, 반복 카운터 = rcr_at_ug */
    t->RCR  = 1u;                  /* 다음 재장전부터 적용 */
    t->SR   = 0u;
    t->CR1 |= TIM_CR1_CEN;
}

int bsp_cs_init(uint32_t *trig_cnt)
{
    HAL_OPAMP_Start(&hopamp1);
    HAL_OPAMP_Start(&hopamp2);
    HAL_OPAMP_Start(&hopamp3);

    HAL_ADCEx_Calibration_Start(&hadc1, ADC_SINGLE_ENDED);
    HAL_ADCEx_Calibration_Start(&hadc2, ADC_SINGLE_ENDED);
    HAL_ADCEx_InjectedStart(&hadc1);
    HAL_ADCEx_InjectedStart(&hadc2);

    /* 두 시작 방법을 시험해서 꼭대기(하강 중, CNT 가 ARR 근처)에서 끝나는 쪽을 쓴다 */
    for (uint32_t rcr0 = 0; rcr0 <= 1u; rcr0++) {
        tim1_restart_with_rcr(rcr0);
        HAL_Delay(2);
        int top = 1;
        uint32_t c = 0, d = 0;
        for (int k = 0; k < 8; k++) {
            if (bsp_cs_trigger_point(&c, &d) != 0 || d == 0u || c < BSP_PWM_ARR / 2u) { top = 0; break; }
        }
        if (top) { *trig_cnt = c; return 0; }
    }
    *trig_cnt = 0;
    return -1;
}

void bsp_cs_read_raw(uint16_t *u, uint16_t *v, uint16_t *w)
{
    *u = (uint16_t)HAL_ADCEx_InjectedGetValue(&hadc1, ADC_INJECTED_RANK_1);
    *v = (uint16_t)HAL_ADCEx_InjectedGetValue(&hadc2, ADC_INJECTED_RANK_1);
    *w = (uint16_t)HAL_ADCEx_InjectedGetValue(&hadc2, ADC_INJECTED_RANK_2);
}

/**
 * app_main() 을 구현하지 않은 프로젝트를 위한 기본 구현.
 * 링크 에러 대신 LED 100ms 점멸 — "실험 코드가 안 붙었다"를 보드에서 바로 알 수 있게.
 */
__attribute__((weak)) void app_main(void)
{
    while (1)
    {
        bsp_led_toggle();
        HAL_Delay(100);
    }
}
