SeoKeon/Robot-Control-Lab/platform/g431-esc1/bsp/Inc/bsp.h

/**
 * bsp.h — B-G431B-ESC1 보드 공용 계층
 *
 * 실험마다 반복되는 보드 의존 코드를 여기에 모은다.
 * 실험 코드는 이 헤더만 include하면 된다.
 */
#ifndef BSP_H
#define BSP_H

#include "main.h"   /* CubeMX 생성 핀 정의 + stm32g4xx_hal.h */

#ifdef __cplusplus
extern "C" {
#endif

/* --- 온보드 LED (LD2 = PC6) ---------------------------------------------- */
#define BSP_LED_PORT  LD2_GPIO_Port
#define BSP_LED_PIN   LD2_Pin

void bsp_led_on(void);
void bsp_led_off(void);
void bsp_led_toggle(void);

/* --- 시리얼 (USART2 -> 도터보드 ST-LINK VCP, 115200 8N1) ------------------
 * 핀: PB3=TX, PB4=RX  (UM2516 Table 4)
 * USB 케이블 하나로 디버깅과 시리얼이 동시에 된다.
 */
void bsp_uart_write(const uint8_t *data, uint16_t len);
void bsp_uart_puts(const char *s);

/**
 * 비동기 송신 모드. 켜면 write 는 2 KB 큐에 넣고 바로 돌아오고, 실제 송신은 USART2
 * TXE 인터럽트가 한다 — 제어 루프 안에서 찍어도 루프가 멈추지 않는다.
 * 블로킹 송신(115200 baud)은 70바이트에 약 6 ms 걸린다. 큐가 차면 넘친 바이트는 버린다.
 * 끄면(0) 큐가 빌 때까지 기다린 뒤 블로킹 모드로 돌아간다. 반환: 지금까지 버린 바이트 수.
 */
uint32_t bsp_uart_set_async(int on);

/**
 * printf 형식 송신. 한 번에 최대 255바이트(넘으면 잘린다. 한글은 글자당 3바이트).
 * 주의: %f 는 기본으로 동작하지 않는다 — newlib-nano 는 float 포맷을 빼고
 *       링크한다. 필요하면 링커 옵션에 -u _printf_float 를 추가할 것.
 *       당장은 정수로 스케일해서(예: 밀리단위) 찍는 쪽이 싸고 빠르다.
 */
void bsp_printf(const char *fmt, ...);

/* --- 3상 PWM (TIM1) ------------------------------------------------------
 * U: CH1  PA8  / CH1N PC13      (UM2516 Table 4)
 * V: CH2  PA9  / CH2N PA12
 * W: CH3  PA10 / CH3N PB15
 *
 * Center-aligned, ARR=4249 -> 20kHz. 데드타임 DTG=149 -> 1us.
 *
 * ⚠️ TIM1_BKIN 이 MCU 에 연결돼 있지 않다 = 하드웨어 과전류 차단이 없다.
 *    전원공급장치의 전류 리밋이 유일한 실질 보호장치다.
 * ⚠️ 게이트 드라이버 EN 핀이 없다. 출력을 끊는 유일한 수단이 bsp_pwm_stop() 이다.
 */
#define BSP_PWM_ARR       4249u   /* .ioc 의 Period 와 반드시 일치 */

/**
 * 브링업 안전 상한. 듀티는 이 값을 넘지 못하게 클램프된다.
 * 12V / 상간 21Ω 이므로 듀티 100% 여도 모터 전류는 0.57A 지만,
 * 배선이나 설정 실수를 여기서 한 번 더 막는다.
 * 올릴 때는 전원 전류 리밋을 먼저 확인하고 의도적으로 올릴 것.
 */
#define BSP_PWM_DUTY_MIN  0.20f
#define BSP_PWM_DUTY_MAX  0.80f

/** 듀티 0 으로 맞춘 뒤 6채널(상보 포함) 출력을 시작한다. */
void bsp_pwm_start(void);

/** 6채널 출력을 끊는다. MOE=0 -> Idle State(Reset) = 6게이트 전부 off. */
void bsp_pwm_stop(void);

/** 각 상 듀티 0.0~1.0. BSP_PWM_DUTY_MIN/MAX 로 클램프된다. */
void bsp_pwm_set_duty(float du, float dv, float dw);

/**
 * 전기각 theta_e[rad] 방향으로 크기 m(0.0~1.0)의 전압 벡터를 인가한다.
 * 사인 변조(3차 고조파 주입 없음) — 선간 최대 진폭은 m x Vbus x sqrt(3)/2.
 * m=0.30, Vbus=12V 이면 선간 약 3.1V -> 21Ω 에서 약 0.15A.
 */
void bsp_pwm_set_vector(float theta_e, float m);

/* --- AS5600 자기 엔코더 (I2C1: PB7=SDA, PB8=SCL, 100kHz) -------------------
 * J8 커넥터 경유. 보드 홀입력 회로의 +3.3V 10K 풀업을 그대로 쓴다.
 * 주소 0x36 고정. 12비트(0~4095) = 기계각 1회전.
 */
#define BSP_AS5600_ADDR   0x36u
#define BSP_AS5600_CPR    4096u   /* counts per revolution */

/** I2C 버스 스캔 — 응답한 7비트 주소를 시리얼로 출력. 배선 검증용 */
void bsp_i2c_scan(void);

/**
 * 자석 상태 확인. 1=정상(MD, 자석 감지), 0=문제.
 * detail 이 NULL 이 아니면 STATUS 레지스터 원값(0x0B)을 넣어준다:
 *   bit5 MD=자석 감지, bit4 ML=자석 너무 약함/멀다, bit3 MH=너무 강함/가깝다
 */
int bsp_as5600_magnet_ok(uint8_t *detail);

/**
 * 기계각 원시값 읽기 (RAW ANGLE 0x0C/0x0D, 0~4095).
 * 성공 시 0, 실패(I2C 에러) 시 -1.
 */
int bsp_as5600_read_raw(uint16_t *raw);

/** AGC(자동 게인) 읽기. 3.3V 모드에서 0~128, 클수록 자석이 멀다. 이상적 ~64 */
int bsp_as5600_read_agc(uint8_t *agc);

/**
 * 내부 필터 설정 (CONF 0x07 의 SF, FTH). 휘발성 — 전원을 끄면 기본값으로 돌아간다.
 *   sf : 0 = 16x (기본, 스텝 응답 약 2.2 ms)  1 = 8x  2 = 4x  3 = 2x (약 0.29 ms)
 *   fth: 0 = 느린 필터만 (기본). 1~7 = 각도 변화가 임계값을 넘으면 빠른 필터로 전환
 * 느릴수록 정지 노이즈가 작고, 빠를수록 회전 중 각도 지연이 작다.
 * 성공 시 0. conf_out 이 NULL 이 아니면 써넣은 뒤 다시 읽은 CONF(16비트)를 준다.
 */
int bsp_as5600_set_filter(uint8_t sf, uint8_t fth, uint16_t *conf_out);

/* --- 전류 센싱 (3션트) ----------------------------------------------------
 * 션트 → OPAMP1/2/3 (PGA ×16, 반전입력 IO0 = 보드 바이어스) → 내부 연결 →
 *   U: ADC1 injected rank1 (VOPAMP1)
 *   V: ADC2 injected rank1 (VOPAMP2)
 *   W: ADC2 injected rank2 (VOPAMP3)
 * 트리거: TIM1 TRGO(Update), RCR=1 → PWM 주기당 1회.
 *   **카운터 꼭대기**에서 샘플해야 한다 — 그때 하단 MOSFET 3개가 모두 ON 이라
 *   션트에 상전류가 흐른다. 바닥에서는 상단이 ON 이라 션트 전류가 0 이다.
 *   bsp_cs_init() 이 실제 트리거 시점을 재서 꼭대기로 맞춘다.
 *
 * 환산: 션트 3 mΩ, 유효 게인 −9.14 V/V (NuttX / SimpleFOC 의 이 보드 값)
 *   → 1 count = 3.3/4096 / (0.003 × 9.14) ≈ 29.4 mA, 부호 반전.
 *   이 보드는 40 A 급이라 0.2 A 급 모터에선 몇 count 밖에 안 된다 — 평균이 필요하다.
 */
#define BSP_CS_A_PER_COUNT   (-0.02938f)

/**
 * OPAMP 시작, ADC 보정, injected 변환 대기 시작, TIM1 카운터를 돌려 트리거를
 * 꼭대기에 정렬한다. **PWM 출력을 켜기 전에** 한 번 부른다.
 * 반환: 0 = 꼭대기 정렬 성공, -1 = 실패. trig_cnt 에 변환 직후 카운터 값.
 */
int  bsp_cs_init(uint32_t *trig_cnt);

/** 가장 최근 PWM 주기의 세 상 ADC 원시값 (0~4095) */
void bsp_cs_read_raw(uint16_t *u, uint16_t *v, uint16_t *w);

/** 진단: 다음 변환이 끝난 순간의 TIM1 카운터 값과 방향(1=하강). 실패 시 -1 */
int  bsp_cs_trigger_point(uint32_t *cnt, uint32_t *dir_down);

/* --- 앞으로 추가될 자리 ---------------------------------------------------
 * CubeMX(platform/g431-esc1/g431-esc1.ioc)에서 주변장치를 켤 때마다
 * 여기에 래퍼를 추가한다. 실험 코드가 레지스터/핀을 직접 만지지 않게.
 *   예) bsp_pwm_set_duty(), bsp_current_read_abc(), bsp_encoder_read_angle()
 * 핀 배치는 .ioc 를 정본으로 삼고, 확인한 것만 여기에 적는다.
 * ------------------------------------------------------------------------ */

/**
 * 실험별 진입점. 각 실험 프로젝트가 이 함수를 구현한다.
 * main()이 HAL_Init / 클럭 / 주변장치 초기화를 끝낸 뒤 호출하며, 돌아오지 않는다.
 * 구현하지 않으면 bsp.c의 weak 기본 구현(LED 빠른 점멸)이 링크된다.
 */
void app_main(void);

#ifdef __cplusplus
}
#endif

#endif /* BSP_H */
