SeoKeon/Robot-Control-Lab/(commit log)

2026-07-21 레포 초기 구성: 폴더 구조, 기록 규칙
2026-07-21 레포 초기 구성
2026-08-01 2026-08-01-parts-testing 만들기
2026-08-19 platform: 보드 공용 계층 분리 (HAL/CMSIS 중복 제거)
    보드(B-G431B-ESC1)는 항상 같은데 실험마다 CubeMX 프로젝트가 통째로 복제되어
    Drivers/(HAL+CMSIS, 90여 파일 / 4.6MB)가 실험 수만큼 늘어나는 구조였다.
    주변장치를 켤 때마다 사본이 갈라져 어느 게 최신인지도 추적이 안 된다.
    보드에 종속된 것과 실험에 종속된 것을 갈라놓았다.
    - platform/g431-esc1/ 신설: Core/, Drivers/, startup, 링커스크립트,
    툴체인 cmake, .ioc(g431-esc1.ioc) 를 한 벌만 둔다
    - platform.cmake 의 add_lab_firmware() 로 빌드. HAL 소스는 glob(CONFIGURE_DEPENDS)
    이라 CubeMX에서 주변장치를 켜도 CMa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
2026-08-19 log: 2026-08-19 보드 공용 계층 분리와 빌드 경로 정리
    빌드 경로 정리:
    - .vscode/tasks.json 신설 — build / flash 태스크.
    셸 명령이 아니라 type:"cmake" 로 CMake Tools 에 위임했다. 상태바 빌드
    버튼(F7)과 같은 cmake 를 쓰므로 build/Debug 의 CMakeCache 가 어긋나지 않는다
    (터미널은 CubeCLT 의 cmake, VS Code 는 확장의 cube-cmake — 툴체인이 두 벌이다)
    - launch.json 에 preLaunchTask: "build" 연결. 08-05 로그 문제 4(빌드 안 하고 F5)의
    해결책이 문서에만 있고 실물에는 없던 상태였다. launch.json 은 .gitignore
    대상이라 이 변경은 로컬에만 남는다
    - .gitignore 에 !**/.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
2026-08-19 C.V, C.C에 대해 알게된 내용을 다시한번 정리함
2026-08-19 notes: ARM 툴체인·빌드 파이프라인 / ST 도구·디버그 스택 정리
    STM32 셋업·디버그 구성·컴파일러가 약해서 개념을 노트로 남긴다.
    두 주제라 규칙 1(주제 하나 = 글 하나)대로 글을 나눴다.
    - notes/2026-08-19-arm-toolchain-and-build-pipeline.md
    arm-none-eabi- 이름 해독, .c→.o→.elf→.hex 파이프라인, 링커스크립트,
    섹션과 메모리맵(.data 가 FLASH·RAM 양쪽에 있는 이유), 부팅 순서와
    진입점이 홀수인 이유(Thumb 비트), 컴파일 플래그별 의미, CMake 2단계
    - notes/2026-08-19-stm32-tooling-and-debug-stack.md
    CubeMX/CubeIDE/CubeCLT/CubeProgrammer/확장 경계(확장은 껍데기)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
2026-08-19 log: 2026-08-01 C.V/C.C 정리 내용 복원
    258eac1 에서 직접 정리한 C.V/C.C 설명이 바로 뒤 커밋의 양식 재구성(cfbb2de)에
    덮여 있었다. 파일을 통째로 다시 쓰면서 그 시점 디스크 내용을 반영하지 못했다.
    258eac1 의 표현을 표에 그대로 되살렸다:
    - C.V = 전압을 일정하게 유지
    - C.C = 전류를 일정하게 유지. 저항이 낮아 전류가 튈 때 전압을 그만큼 낮춰 전류를
    고정해주며, 이를 회로 디버깅에 활용할 수 있다
    이해가 두 번 바뀐 과정(상태 -> 기능 -> 전류 고정)도 인용문에 남겼다.
2026-08-20 실습 준비 및 간단한 이론공부 진행
2026-08-25 p0: uart_hello 실험 폴더 스캐폴딩 (UART 미구현)
    p0-setup README 의 완료 기준("Blink + 시리얼 hello")에서 남은 절반.
    platform/g431-esc1/template/ 을 복사해 만들었다 — 문서에 적어둔 절차를
    그대로 따라가며 검증도 겸했다 (-Recurse 로 .vscode/ 까지, @TARGET@ 치환 2곳).
    - 빌드 통과: uart_hello.elf / FLASH 5876B / RAM 1584B
    - blink_test 와 .map 이 타깃별로 분리되는 것 확인 (add_lab_firmware 의 의도)
    - app_main.c 는 아직 UART 를 쓰지 않는다. LED 패턴(짧게 2번 + 긴 정지)으로
    어느 펌웨어가 올라가 있는지만 구분되게 해뒀다
    UART 를 켜려면 VCP 가 어느 페리페럴/핀인지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
2026-08-27 docs: 보드 문서 링크 정리 (회로도·UM2516·L6387)
    핀 확인의 정본이 UM2516 이 아니라 MB1419 회로도라는 것을 명시했다.
    UM2516 은 커넥터·사용법 중심이고, MCU 핀 대 게이트드라이버 결선은 회로도에 있다.
    파워단 부품도 확인해 추가: L6387 게이트 드라이버 x3, STL180N6F7 MOSFET x6.
    데드타임 값의 근거가 L6387 데이터시트의 전파지연 스펙이므로 링크를 걸어뒀다.
    L6387E 에 인터록이 내장돼 있지만 스위칭 과도구간은 못 막으므로
    데드타임은 여전히 필요하다는 점도 적었다.
2026-08-27 docs: 보드 핀맵 확정 — UM2516 Table 4 에서 추출
    "확인 필요"로 비워뒀던 항목을 전부 채웠다. 출처는 UM2516 Rev 4 의
    Table 4 (STM32G431CB pinout for motor control), MB1419 회로도 MCU 시트로 교차 확인.
    3상 PWM (회로도 넷 UH/UL/VH/VL/WH/WL 로 상 배정 확정):
    U = TIM1_CH1 PA8 / CH1N PC13
    V = TIM1_CH2 PA9 / CH2N PA12
    W = TIM1_CH3 PA10 / CH3N PB15
    전류 센싱은 MCU 내장 OPAMP 3개:
    OPAMP1 PA1/PA3 -> PA2, OPAMP2 PA7/PA5 -> PA6, OPAMP3 PB0/PB2 -> PB1
    추정이 틀렸던 것 정정: VCP 는 LPUART1 이 아니라 USART2 (PB3/PB4).
    핀맵에서 바로 나오는 안전 관련 결론 2가지:
    - 게이트 드라이버 EN 핀이 없다.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
2026-08-27 p0: blink 주기 1000ms 로 변경
2026-08-27 p0: USART2 활성화 + bsp 시리얼 래퍼, uart_hello 구현
    CubeMX 로 platform/g431-esc1/g431-esc1.ioc 에 USART2 를 켰다.
    핀은 UM2516 Table 4 대로 PB3(TX)/PB4(RX) — CubeMX 기본값 PA2/PA3 를 옮긴 것이다.
    PA2/PA3 는 나중에 전류 센싱 OPAMP1 이 쓸 핀이라 비워둬야 한다.
    회로도에서 USART2 가 도터보드 ST-LINK(USART2_TX_ST_LINK)로 직결되는 것을 확인했다.
    VCP 로 나오므로 플래싱용 USB 케이블 하나로 시리얼까지 된다.
    - bsp: bsp_uart_write() / bsp_uart_puts() / bsp_printf() 추가.
    huart2 는 CubeMX 가 main.c 에 만든 핸들을 extern 으로 가져다 쓴다.
    %f 는 newlib-nano 에서 기본 비활성이라 주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
2026-08-27 log: 2026-08-27 p0 완료 — 시리얼 hello 뚫기
    p0-setup 완료 기준(Blink + 시리얼 hello)을 채웠다.
    기록한 것:
    - 문서를 눈으로 훑지 않고 pdftotext + grep 으로 UM2516 Table 4 에서 핀맵을
    뽑아낸 과정. -layout 에서 셀이 밀려 PA3/PA4 가 뒤바뀌어 보인 것을 -raw 로
    교차 확인한 것도 남겼다 (핀 하나 틀리면 MOSFET 이 가는 상황이라)
    - "빌드가 되는데 왜 보드 정보가 없나" — .ioc 의 board=custom 이 답이었다.
    빌드에 필요한 건 전부 칩 정보고, 기판 배선은 칩이 알 수 없다는 구분
    - VCP 는 LPUART1 이 아니라 USART2. UM2516 에 VCP 단어가 없어서 회로도에서
    USAR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
2026-08-27 p1: foc-bringup 실험 폴더 스캐폴딩 (TIM1 미설정)
    템플릿 복사 + @TARGET@ 치환으로 생성. 빌드 통과 (foc_bringup.elf).
    아직 모터를 돌리지 않는다. TIM1 이 .ioc 에 없고, 켜기 전에 L6387
    데이터시트에서 데드타임 값을 계산해야 한다. 데드타임 없이 상보 PWM 을
    내면 션트-스루로 MOSFET 이 간다.
    app_main.c 는 준비 상태만 시리얼로 찍고 LED 를 2Hz 로 토글한다.
    필요한 4단계(데드타임 계산 -> CubeMX -> 전원 설정 -> 회전 3단계)를
    주석에 적어뒀다.
    README 에 안전 항목을 표로 고정했다:
    - 전원 전류 리밋 0.8~1A (정상 최대 0.57A = 12V/21Ω 보다 위,
    션트-스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
2026-08-27 docs: projects/README 에 실험 진행 현황 표 추가
    p0-setup 완료 / p1-foc-bringup 진행 중.
2026-08-27 p1: TIM1 설정값 확정 — 데드타임 1us (DTG=149) 유도 기록
    L6387E 데이터시트 Table 5 에서 타이밍을 읽어 데드타임을 계산했다.
    ton 110ns / toff 105ns / tr 50ns / tf 30ns (전부 Typ., 25도).
    Figure 6/7 축이 250ns 까지라 온도에 따라 typ 보다 커진다.
    최소 데드타임:
    (toff_max + MOSFET 게이트 방전) - ton_min = (200 + 250) - 70 = 약 380ns
    첫 브링업은 x2 여유로 1000ns. 이유는 TIM1_BKIN 이 MCU 에 연결돼 있지 않아
    하드웨어 과전류 차단이 없다는 것과, 20kHz 주기 50us 중 1us 는 2% 라
    변조 손실이 사실상 없다는 것.
    DTG 환산 (t_DTS = 1/170MHz = 5.882ns):
    0xx 인코딩은 최대 747n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
2026-08-27 p1: GPIO 출력 속도는 Low 로 통일 — 근거 기록
    PC13 은 CubeMX 에서 Low 밖에 못 고른다. 백업 도메인(RTC/TAMP/WKUP) 쪽 핀이라
    구동 능력이 제한되기 때문이고 정상 동작이다.
    회로도에서 L6387ED 결선을 확인해 문제가 안 되는 이유를 적었다.
    MCU 는 드라이버의 로직 입력(LIN 핀1 / HIN 핀2, 수 pF CMOS)만 흔들고,
    MOSFET 게이트는 드라이버의 LVG(핀5)/HVG(핀7)가 400~650mA 로 구동한다.
    따라서 MCU 슬루율은 데드타임 예산에서 무시할 수준이고 DTG=149 는 그대로 유효하다.
    6개 핀 전부 Low 로 통일한다 — 절대 속도보다 채널 간 skew 가 중요하고
    PC13 이 Low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
2026-08-27 p1: TIM1 3상 PWM 활성화 + bsp PWM 계층, 정지 벡터 테스트
    CubeMX 로 TIM1 을 켰다. 첫 생성에서 채널 모드가 Output Compare 로 잡혀
    OCMode 가 TIM_OCMODE_TIMING(Frozen, 출력에 영향 없음)이 됐던 것을
    PWM Generation 으로 바꿔 TIM_OCMODE_PWM1 로 정정했다.
    생성 코드에서 검증한 값:
    Prescaler 0 / CENTERALIGNED1 / Period 4249 (20kHz) / ClockDivision DIV1
    DeadTime 149 (=1us, CKD=1 기준) / OCPolarity,OCNPolarity HIGH
    OCIdleState,OCNIdleState RESET (정지 시 6핀 Low = MOSFET 전부 off)
    AutomaticOutput DISABLE / BreakState DISABLE (BKIN 배선 없음)
    핀: PA8/PC13, PA9/PA12, PA10/PB15 — GPIO 속도 6개 전부 LOW 로 통일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
    [app_main.c, bsp.c, bsp.h, g431-esc1.ioc]
2026-08-27 p1: 단계(b) 왕복 스윕 — 오픈루프 구동 성공
    모터 선이 함께 회전하는 구조라 기계각 180도가 가동 한계 → 연속 회전 대신
    기계각 ±50도 왕복 스윕으로 설계 변경. ramp()로 전기각을 500Hz 갱신하며
    전기 200→3200 deg/s 5단계로 올렸다.
    실측: 약 100도 왕복(설계값), 전류 0.2A 미만(계산 0.22A), 5단계 전부
    추종·탈조 없음. 오픈루프 한계는 기계 457deg/s(76rpm) 이상.
    단계(a) 반영: m 0.30→0.45 (94도 기대에 70도 추종 — 토크 부족).
    PWM off 시 역방향 미동은 유지토크 상실 후 코깅 디텐트(4.29도) 안착 — 정상.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
2026-08-27 log+notes: 모터 첫 회전 기록 + 공부용 이론 노트 2편
    오늘 세션의 실험 서사와 이론을 분리해서 남긴다. 실험은 대부분 자동화된
    진행이었으므로, 기록은 "왜 그렇게 했는지"가 읽히도록 썼다 — 나중에 읽으며
    공부하는 용도.
    log/2026-08-27-first-motor-rotation.md
    준비(핀맵/데드타임/안전구조) -> 정지 벡터 -> 왕복 스윕 순서로 기록.
    막힌 것 4건: CubeMX Output Compare 는 PWM 이 아니다(OCMODE_TIMING),
    PC13 GPIO 속도 Low 고정(백업 도메인 — L6387 로직 입력이라 무관),
    m=0.30 토크 부족(94도 기대 70도 실측), PWM off 시 코깅 디텐트 안착.
    notes/2026-08-27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
2026-08-29 docs: J8 엔코더 커넥터 I2C 확인 — PB7=SDA, PB8=SCL (PB6/PB7 추정 정정)
    CubeMX 칩 DB 의 AF 목록으로 확정: PB7=I2C1_SDA(B+/H2), PB8=I2C1_SCL(Z+/H3).
    PB6 은 I2C 기능이 없다 — 처음 추정이 틀렸다.
    회로도 확인: J8 센서 라인에 +3.3V 10K 풀업이 이미 있어(홀 입력 회로)
    I2C 외부 풀업 불필요. J8 에 5V/GND 전원도 나온다 (UM2516 5.4).
    PB6/PB7 은 TIM4_CH1/CH2 라 ABI 엔코더 전환 시 TIM4 엔코더 모드 후보.
2026-08-29 docs: AS5600 배선 확정 — 3.3V 는 J4 패드 3번에서
    엔코더 보드가 3.3V 전용(솔더점퍼·구매페이지 확인)인데 J8 은 5V 만 나온다.
    UM2516 Table 6 에서 J4 SWD 패드의 3번이 MCU VDD(3.3V), 4번이 GND 인 것을
    확인했고 회로도에서 J4-3 이 +3.3V 넷에 있는 것도 교차 확인했다.
    최종 배선: VCC->J4-3, GND->J8 GND, SDA->J8 B+/H2(PB7), SCL->J8 Z+/H3(PB8),
    DIR->GND(방향 미정의 방지), OUT/GPO 미연결.
2026-08-29 docs: PB8=BOOT0 겸용 핀 확인 — 옵션 바이트로 무해화돼 있음
    I2C1_SCL 로 쓸 PB8 은 BOOT0 겸용 핀이라 I2C 풀업(리셋 시 High) 때문에
    부트로더로 빠질 수 있는 구조인데, 실측 결과 옵션 바이트가 이미
    nSWBOOT0=0 / nBOOT0=1 (핀 무시, 항상 플래시 부팅)로 설정돼 있다.
    칩 교체나 옵션 바이트 초기화 후 되돌아갈 수 있는 설정이므로,
    "엔코더 꽂으면 부팅 안 됨" 증상의 확인 명령과 함께 기록해둔다.
2026-08-29 p1: I2C1 활성화 + bsp AS5600 드라이버, 엔코더 단독 테스트
    CubeMX 로 I2C1 을 켰다 (PB7=SDA, PB8=SCL, 100kHz, Timing 0x40B285C2).
    첫 시도에서 칩 그림 핀 지정만 하고 Connectivity 의 Mode 를 안 켜서
    MX_I2C1_Init/hi2c1 이 안 생겼던 것을 재생성으로 해결 — 핀 신호 지정과
    주변장치 활성화는 별개 단계다.
    bsp 에 AS5600 드라이버 추가:
    bsp_i2c_scan() 버스 스캔 (배선 검증용)
    bsp_as5600_magnet_ok() STATUS(0x0B) MD/ML/MH — 자석 거리 진단
    bsp_as5600_read_raw() RAW ANGLE(0x0C/0x0D) 12비트
    보드 실측 (PWM 없이 엔코더만):
    - I2C 스캔에서 0x36 응답, 연속 읽기 수백 회 에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
2026-08-29 p1: AS5600 정렬 진단 모드 + 자석 미포함 확인 — 자석 대기
    bsp 에 bsp_as5600_read_agc() 추가 (AGC 0x1A — 자동 게인, 거리 미터로 쓸 수
    있다. 3.3V 모드 0~128, 클수록 자석이 멀다). app_main 을 정렬 진단 모드로:
    200ms 마다 MD/ML/MH + AGC + raw 를 찍어 보드를 움직이며 실시간 정렬.
    보드 실측: 위치를 바꿔도 60초 내내 AGC=128(최대 고정), MD=0.
    사진 확인 결과 축 끝에 엔코더용 원판 자석이 아예 없다 — 모터에 미포함.
    raw 가 2800~3500 을 떠돌던 것은 로터 링 자석의 누설 자기장으로 추정.
    I2C 경로 자체는 완전 검증 상태 (0x36 응답, 읽기 에러 0건). 지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
2026-08-29 p1: 2804 모터 기구 규격 추가 — 장착 나사 M2 확정
    검색으로 확인: 베이스 4xM2(12mm 원주), 로터 4xM2(20.5/16mm 원주),
    O34x15mm 41.5g, 스펙 상저항 11.2옴 — 실측 10.5옴(상간 21옴/2)과 일치해
    측정 교차 검증도 됐다. 지그용 서포트는 M2.5 가 아니라 M2 로 살 것.
    원주 지름은 판매처별로 달라 플레이트 가공 전 실측 필요.
2026-08-29 p1: 오픈루프 연속회전 + 엔코더 로깅 — 자석 미끄러짐 발견
    명령각 vs 실제각 동시 로깅 실험. 엔코더 언랩(랩어라운드 누적), 부호
    자동판정(전기 1바퀴 = 기계 51.4도 기대), 두 속도 정방향 + 역방향 각
    기계 1바퀴, 100ms 마다 cmd/enc/err 출력.
    시스템 통합은 성공: PWM 구동 + I2C 읽기 + 시리얼이 동시 동작, 연속
    회전 3바퀴 완주, 역방향에서 err 부호 반전(추종 지연 관측)도 확인.
    그러나 드리프트가 재현되지 않는다:
    1차: 부호판정 90.9도(기대 51.4), 최종 오차 -44.0도
    2차: 부호판정 64.0도, 최종 오차 -21.6도
    같은 명령에 매번 다른 오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
2026-08-29 log+notes: 엔코더 브링업 기록 + 자기식 엔코더 이론 노트
    세션 대부분이 자동 진행이었으므로, 나중에 읽으며 공부할 수 있게
    "왜 그렇게 판단했는지"가 드러나도록 썼다.
    log/2026-08-29-encoder-bringup.md
    배선 확정(전부 문서 근거) -> 스캔 OK -> ML=1 -> 자석 부재 발견 ->
    장착 -> 추종 확인 -> 통합 실험(연속회전+로깅) 순서로 기록.
    막힌 것 4건: CubeMX 핀 지정 != 주변장치 활성화, PB8-BOOT0 와 옵션
    바이트(nSWBOOT0=0 실측), AGC=128 로 자석 부재를 정량 진단,
    드리프트 비재현 -> 원인 둘(미끄러짐 vs PWM 간섭)로 가르고 판별
    실험(무전원 손돌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
2026-10-10 p1: 손돌리기 판별 테스트에 I2C 스캔 + MD/AGC 출력 추가
    지그 조립 후 재개. 판별 펌웨어를 플래싱해 보니 출력이 전부 0 (AGC 까지 0)
    — I2C 읽기 실패 시 드라이버가 0 을 남기는 패턴. 부팅 시 스캔을 넣어
    확인한 결과 "I2C1 scan: (0개)": 지난번 응답하던 0x36 이 사라졌다.
    SWD 플래싱은 정상이므로 J4 패드 주변은 무사하고, 지그 작업 중 엔코더
    4가닥(VCC/GND/SDA/SCL) 중 하나가 끊어진 것으로 판단.
    매 줄 MD/AGC 를 같이 찍게 해서, 배선 복구 후 같은 펌웨어로
    간격(AGC)과 손돌리기 정확도(720도)를 한 번에 볼 수 있다.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
2026-10-10 p1: 모터 장착 나사 규격 정정 — 베이스 M2.5 (실측)
    웹 스펙을 보고 베이스 4xM2 로 적었으나 지그 설계 때 실측값은 베이스
    M2.5(홀 원 약 19.8mm), 로터 M2(배치 원 약 12.8mm)였다. 중공축 실측
    (내경 4.7mm, 돌출 0, 높이 14mm)도 함께 기록. 출처는 files/ 의 지그
    인수인계 문서.
2026-10-10 hardware: 테스트 거치대를 hardware/foc-test-stand/ 로 정리
    d6fdc60 에서 실수로 같이 올라간 files/(11MB, 3D 프린팅 지그)를 정리했다.
    지그는 p1 만이 아니라 이후 모터 실험이 같이 쓰는 기구물이라, 보드 공용
    펌웨어를 platform/ 에 두는 것처럼 기구 공용 자산을 hardware/ 에 둔다.
    foc_test_stand.py CadQuery 원본 (정본). out/ 은 스크립트 위치 기준이라
    옮겨도 그대로 동작한다
    print/ 실제로 출력한 v4 3MF 3종
    img/ 조립 렌더, 단면도
    README.md Cowork 인수인계 문서를 설계 설명서로 정리. 세션 안내는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
2026-10-10 p1: I2C 버스 진단 루틴 — 핀 레벨 + 비트뱅 양방향 스캔
    배선을 다시 연결했는데도 0x36 이 안 보여서, 하드웨어 I2C 를 잠시 끄고
    핀을 직접 보는 진단을 부팅 시 돌리게 했다.
    [1] 대기 레벨(풀 없음) [2] 내부 풀다운을 걸어도 High 인지(보드 10K 풀업 확인)
    [3] 버스 복구(SCL 9발 + STOP) 후 비트뱅 스캔을 정상 배선과 SDA/SCL 뒤바뀐
    배선 두 방향으로 [4] 하드웨어 I2C 재초기화 후 재스캔 + 자동 판정 줄
    결과: BUSY=0, SDA/SCL 모두 High(풀다운 걸어도 High = MCU 쪽 풀업 정상),
    비트뱅 양방향 모두 0개, 재스캔 0개 -> MCU·보드 쪽은 정상이고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
2026-10-10 p1: 버스 진단 판정 문구 정정 + 지그에서 처음으로 MD=1
    원인은 지그 조립 중 빠진 엔코더 선 하나였다 (재연결 후 0x36 응답).
    소프트웨어 스캔이 응답할 때 '하드웨어 I2C 가 걸려 있었다' 고 단정하던
    판정 문구를 고쳤다 — 이번처럼 단선이 원인일 때도 그렇게 찍혔다.
    지그 장착 상태 실측: MD=1 (테이프 고정 때는 0), AGC=128, 정지 raw 2587
    에서 흔들림 0. 감지 문턱은 넘었지만 AGC 가 최대라 스페이서로 간격을 더
    줄여야 여유가 생긴다.
2026-10-10 p1: 통합 실험 2차 준비 — 's' 수신 후 통전, 회전 중 AGC 로깅
    지그 장착 후 엔코더 상태가 바뀌어 통합 실험을 다시 돌린다.
    - 스페이서 1mm 로 MD=1 / AGC=21 (스페이서 없을 때 AGC=128)
    - 무전원 손돌리기 737.1도 = 720 + raw 차 17.1 -> 바퀴 수 정확 일치,
    센서·언랩은 PWM 없을 때 깨끗하다
    남은 의심은 PWM 자기장 간섭 하나라서:
    - 부팅 시 정지 상태 MD/AGC 를 기준값으로 찍고
    - 회전 로그 매 줄에 AGC 를 붙였다 (간섭이 있으면 회전 중 출렁인다)
    - 5초 카운트다운 자동 통전 대신 시리얼 's' 를 받아야 시작한다.
    12V 연결 전 부팅돼도 P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
2026-10-10 log: 2026-10-10 지그 장착과 엔코더 검증 — 드리프트 -44도에서 ±1도로
    08-29 의 비재현 드리프트(1차 -44도 / 2차 -21.6도)를 해소했다.
    지그 조립 후 I2C 가 죽어 있던 것은 빠진 선 하나 — 버스 진단 루틴(레벨,
    풀다운, 버스 복구, 양방향 비트뱅 스캔)으로 MCU 쪽 정상을 확인하고 좁혔다.
    무전원 손돌리기 737.1도 = 720 + raw 차 17.1 로 바퀴 수 정확 일치.
    스페이서 1mm 로 AGC 128 -> 21.
    통합 실험(오픈루프 연속 회전 + 엔코더 로깅) 2회:
    부호판정 50.2 / 50.3도 (기대 51.4), 최종 오차 -1.1 / +0.7도,
    구간 평균 오차 0.9~1.5도로 재현, 회전 중 AGC 24 고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
2026-10-10 p1: 전기각 오프셋 캘리브레이션 + 엔코더 기반 정류 펌웨어
    엔코더를 "읽는" 단계에서 "쓰는" 단계로.
    캘리브레이션: 전기각을 30도씩 앞으로 1바퀴, 뒤로 1바퀴 돌리며 매 위치에서
    offset = θe − sign·PP·θm 을 구해 원형 평균한다. 한 점 정렬보다 정확하고,
    앞/뒤 평균 차로 마찰 지연(히스테리시스)도 같이 나온다. 2회 반복해 재현성 확인.
    1바퀴 기계 이동량으로 부호와 극쌍수(기대 51.4도)도 다시 검증한다.
    정류: 매 루프 엔코더 절대각으로 전기각을 계산하고 벡터를 θe ± 90도에 세운다
    (전압 모드 FOC — 전류 센서 없이 m 으로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
2026-10-10 p1: 정류 펌웨어를 명령 방식으로 — 손 안 대는 주행과 브레이크 테스트 분리
    한 번에 이어서 돌리면 언제 손을 대야 할지 헷갈린다는 피드백에 따라, 시리얼
    명령으로 단계를 나눴다. c=캘리브레이션, r=손 안 대는 주행(저속 정방향 5s ->
    정방향 5s -> 감속 -> 역방향 5s), b=브레이크 테스트(정방향 20s, 그동안 아무
    때나 누름). 실행 사이 PWM off, 오프셋은 RAM 에 유지해 재캘리브레이션 없이
    여러 번 돌릴 수 있다.
2026-10-10 log+notes: 2026-10-10 첫 클로즈드루프 — 오프셋 캘리브레이션 + 엔코더 기반 정류
    엔코더 각도를 써서 벡터를 항상 로터 +90도(전기)에 세우는 전압 모드 FOC.
    캘리브레이션: 24점(30도 간격 앞/뒤) 원형 평균, 2회 반복.
    오프셋 -72.5 / -72.5 도(전기), 차이 0.0. 1바퀴 51.4 / 51.6 도(극쌍수 7 재확인),
    흩어짐 최대 7.9도, 앞뒤 차 -0.1도.
    손 안 대는 주행: m=0.25 211rpm / m=0.30 255rpm / 역방향 -251rpm, 소리 없음.
    정/역 대칭(1.6%)이 오프셋의 독립 검증, 211/0.25 = 845 ≈ 255/0.30 = 850 은
    속도 ∝ 전압(역기전력 균형). 전류: 정지 벡터 0.2A, 회전 0.13A.
    브레이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
2026-10-10 p1: 전류 센싱 브링업 — OPAMP PGA x16 + ADC injected, 꼭대기 샘플링
    CubeMX: OPAMP1/2/3 를 PGA IO0_BIAS 모드(게인 16, high speed, 공장 트림,
    내부 출력)로, ADC1(VOPAMP1) / ADC2(VOPAMP2, VOPAMP3) injected 를 TIM1 TRGO
    rising 으로, ADC 클럭 SYNC_PCLK_DIV4(42.5MHz). TIM1 에 RCR=1, TRGO=Update.
    설정값은 SimpleFOC 의 이 보드용 소스와 NuttX 보드 문서(션트 3mΩ, PGA 16,
    유효 게인 -9.14)로 교차 확인했다. CONFIGURE_DEPENDS 글롭이 새 HAL(adc, opamp)
    11개를 CMake 수정 없이 잡았다.
    bsp 전류 센싱 계층:
    bsp_cs_init() OPAMP 시작, ADC 보정, injected 대기, 그리고 트리거를 카운터
    꼭대기에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
2026-10-10 log: 2026-10-10 전류 센싱 브링업 — 정지 벡터에서 세 상 전류 확인
    정지 벡터(m=0.45) 0/120/240도에서 세 상 전류 측정:
    0도 U +233.6 / V -102.9 / W -132.3 mA, 합 -1.6
    120 -124.8 / +260.6 / -145.8, 합 -10.1
    240 -123.1 / -106.1 / +219.0, 합 -10.1
    예측 약 260mA(선간 4.05V / 15.75옴)와 1 count(29mA) 안에서 일치. 큰 값이
    U->V->W 로 옮겨가 상 배치와 ADC 매핑 확인, 세 상 합 ≈ 0 으로 채널 간 게인·영점
    일치 확인, 부호(상 안으로 = +) 확인. PWM 중에도 트리거 꼭대기 유지(CNT 4112).
    로그에는 설정값 확정 근거(SimpleFOC 소스, NuttX 문서), 꼭대기/바닥 샘플링 함정과
    측정으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
2026-10-10 p1: 전압 모드 정류 중 전류 dq 관측 (Clarke/Park)
    2587dce 의 캘리브레이션 + 정류 펌웨어에 전류 센싱을 합쳤다. 매 루프 세 상 전류를
    읽어 Clarke(진폭 불변형, 세 상 모두 사용) -> Park(엔코더 전기각) 으로 id, iq 를
    계산하고 100ms 평균과 한 샘플 σ 를 찍는다. 아직 제어에는 쓰지 않는다.
    기대: 벡터가 q축(θe+90)에 있으므로 id ≈ 0, iq 는 정방향 + / 역방향 -,
    누르면 iq 증가. σ 는 전류 루프가 매 주기 보게 될 노이즈의 크기.
    부팅 시 bsp_cs_init 으로 트리거를 꼭대기에 정렬하고, 명령마다 PWM off 상태에서
    영점을 새로 잰다(온도 드리프트 대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
2026-10-10 p1: dq 관측 결과 + AS5600 필터 비교 실험 준비
    dq 관측 (전압 모드 정류, m=0.30):
    무부하 249 rpm: id +45 / iq +31 mA (역방향 id +43 / iq -31)
    꽉 잡아 정지: id +0.6 / iq 159 mA (계산 171 mA 의 93%)
    iq 부호와 정지 시 크기가 맞고 정지 시 id ≈ 0 -> 각도·오프셋·Clarke·Park 는 정확.
    id 는 방향과 무관하게 + 이고 속도에 비례(0.18 mA/rpm) -> 오프셋 오차가 아니라
    속도 의존 효과. 인덕턴스 가설(id = ωL·iq/R)은 구간별로 L 이 18->81 mH 로 들쭉날쭉해
    기각, 각도 지연 가설(id ∝ ω, iq 무관)이 맞는다. 249 rpm 에서 역산하면 약 1.8 ms
    = 전기각 약 18도 — AS5600 내부 s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
2026-10-10 log: 2026-10-10 dq 전류 관측 — 각도 지연 1.7ms 를 찾아 절반으로
    AS5600 필터 비교 (m=0.30 정방향, 같은 조건):
    A 16x(기본) 250 rpm id 43.3 iq 30.9 mA 지연 17.7도 = 1.68 ms 정지 σ 0.5 count
    B 2x 262 rpm id 24.1 iq 21.2 mA 지연 9.2도 = 0.83 ms 정지 σ 0.4
    C 16x+FTH 262 rpm id 24.8 iq 21.7 mA 지연 9.5도 = 0.87 ms 정지 σ 0.5
    필터를 빠르게 하니 지연이 절반이 되고 같은 전압에서 속도가 올랐다 — 각도 정확도가
    곧 토크. 이 칩은 정지 노이즈가 1 count 미만이라 빠른 필터의 노이즈 손해가 없었다.
    B 를 채택: C 와 결과는 같지만 C 는 속도에 따라 필터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
2026-10-10 p1: 각도 외삽 보정(θ + ω·τ) + 부팅 시 AS5600 SF=2x, τ 스윕 실험
    필터 비교 결과 SF=2x 를 표준으로 채택 — 부팅마다 설정한다(CONF 는 휘발성).
    남은 지연(약 0.85 ms, 대부분 I2C 읽기)은 각도를 앞당겨 보정한다:
    θ_보정 = θ + ω·τ
    ω 는 DWT 사이클 카운터로 루프 간격을 재고 엔코더 누적 변화량으로 계산해
    5 ms 1차 저역통과로 평활한다. PWM 벡터와 Park 변환 둘 다 보정 각도를 쓴다.
    'x' = τ 스윕: 정방향 τ 0 / 0.4 / 0.8 / 1.2 ms 각 3초, 이어서 역방향 0.8 ms.
    id 가 0 을 지나는 τ 가 실제 지연이고, 과보정이면 id 가 음수로 넘어간다.
    필터 비교(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
2026-10-10 p1: τ 스윕 결과 — 각도 외삽 τ=0.85ms 고정, 무부하 id 45 -> 2~4 mA
    정방향 m=0.30, SF=2x 에서 τ 별 무부하 id:
    0 ms +23.1 / 0.4 ms +13.9 / 0.8 ms +2.0 / 1.2 ms -9.2 mA, 역방향 0.8 ms +4.2 mA
    id 가 τ 에 대해 직선으로 줄어 0 을 지나고, 교차점 0.87 ms 는 필터 비교에서
    역산한 0.85 ms 와 같다. τ 기본값을 0.85 ms 로 고정(TAU_LAG_S). 필터 비교('f')는
    필터 자체의 지연을 보는 실험이라 그동안만 보정을 끈다.
    rpm 은 τ 0.8 -> 1.2 ms 사이에서 거의 안 변했다(266.9 -> 267.6). 토크 ∝ sin(앞섬각)
    이 90도 근처에서 평평하기 때문 — 정렬 지표로는 속도보다 id 가 훨씬 민감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
2026-10-10 p1: 전류 루프 (FOC) — iq 지령, id=0, 피드포워드 + 적분기
    플랜트는 L/R 이 루프 주기(약 0.54 ms, I2C 가 정함)보다 짧아 사실상 저항이다:
    다음 루프의 전류 ≈ (V - E)/R. 그래서 d/q 각각
    V = 피드포워드 + 적분기
    피드포워드 Vq = R·iq_ref + ψ·ω (R=10.5Ω 실측, ψ=8.14 mV·s 를 τ 스윕 데이터에서
    E = Vq - R·iq 로 계산)
    적분 게인 KI = 0.2·R (루프마다 오차 20% 감소 — 샘플 σ 약 30 mA 노이즈에 둔감하게)
    전압 크기 m <= 0.40 으로 제한, 포화 중 적분 정지(anti-windup). 100 ms 평균
    |iq| > 0.3 A 또는 1200 rpm 초과 또는 'q' 면 정지.
    '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
2026-10-10 log: 2026-10-10 전류 루프 — FOC 완성, 잡아도 명령한 전류만 흐른다
    브레이크 테스트 (iq 지령 100 mA): 꽉 잡은 정지 구간 86 샘플(약 9초) 평균
    iq 100.0 mA / id 0.0 mA, 제어기가 찾은 전압 m 19.4% = 1.16 V (계산 R·0.1A = 1.05 V).
    전압 모드는 같은 상황에서 V/R = 159 mA 였다. 살짝 누르면 속도가 준 만큼 역기전력이
    줄어 iq 가 지령 쪽으로 올라가는 중간 상태도 보였다 (180 -> 82 rpm, iq 66 -> 83 mA).
    손 안 대는 확인: 지령 0 이면 전류 0 (토크 0, 놓아준 상태), 전압 여유가 있으면 지령을
    정확히 따름(-40 -> -39.3 mA), 무부하에선 360 rpm 에서 전압 한계에 닿아 iq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
2026-10-10 notes: 단계별 공부 로드맵 + Clarke·Park/전류 루프 이론 노트
    공부할 것이 각 로그의 '다음'과 노트의 '실습 연결'에 흩어져 있고, 노트 목록이
    날짜순이라 단계별 길잡이가 없었다. 오늘 한 전류 센싱·dq·전류 루프는 실험 로그만
    있고 이론 노트가 없었다.
    notes/README.md 맨 위에 공부 로드맵: 단계(개발환경 / 첫 회전 / 엔코더 / 전압 모드 /
    전류 FOC / 속도 루프(진행) / 위치 루프 / 로봇팔·보행)마다 볼 로그·노트를 묶고
    스스로 답해볼 질문을 붙였다. 다음 단계는 공부할 개념 목록. 단계가 끝날 때마다 갱신.
    notes/2026-10-10-clarke-park-and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
2026-10-10 p1: 속도 루프 (속도 PI -> iq 지령) + d축 우선 전압 제한
    캐스케이드 바깥 루프: 속도 오차 -> PI -> iq 지령 (±150 mA 제한) -> 기존 전류 루프.
    플랜트 J·dω/dt = Kt·iq 로 게인을 정했다:
    J ≈ 5e-6 kg·m² (가속 데이터 역산), Kt = 1.5·7·ψ ≈ 0.086 N·m/A
    목표 대역폭 5 Hz -> Kp = J·ωc/Kt ≈ 1.8e-3 A/(rad/s), Ki = Kp·ωc/4
    iq 지령이 한계에 닿으면 오차가 한계를 더 미는 방향일 때 속도 적분을 멈춘다.
    전류 루프 전압 제한을 d축 우선으로 바꿨다: |Vd| 를 먼저 지키고 남는
    sqrt(Vmax² - Vd²) 안에서 Vq. 축별로 포화 방향일 때만 적분 정지.
    (이전 균등 축소에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
2026-10-10 p1: 속도 계단 응답 데이터 + 대역폭 비교 명령 'v'
    첫 계단 응답(5 Hz): 평균 속도는 지령과 일치(99.9 / 199.3 / -150.3 rpm),
    id 는 내내 ±1 mA, 전압 포화 0%. 그러나 100 ms 평균 속도가 sd 26~32 rpm 으로
    출렁이고, 그 주기가 속도와 무관하게 정확히 기계 한 바퀴(100 rpm 0.6 s,
    200 rpm 0.3 s, 150 rpm 0.4 s)다. iq 는 속도와 반대로 움직인다(느릴 때 큼)
    -> 한 바퀴에 한 번 걸리는 실제 부하 토크(약 ±1.3 mN·m)를 루프가 못 누르는 것.
    5 Hz 의 비례 강성 Kp·Kt 로는 그 토크가 수십 rpm 오차가 된다.
    대역폭을 단계별로 지정할 수 있게 했다 (cl_step_t.bw_hz, 0 이면 5 H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
2026-10-10 p1: 속도 루프 대역폭 비교 결과 — 기본 15 Hz 로
    100 rpm, 100 ms 평균 속도 (처음 0.3 s 제외):
    5 Hz (Kp 1.83 mA/(rad/s)) 평균 99.5 sd 52.1 범위 -2 ~ 168 (한 바퀴마다 거의 멈춤)
    10 Hz (Kp 3.67) 평균 100.3 sd 12.1 범위 73 ~ 127
    15 Hz (Kp 5.51) 평균 100.1 sd 5.0 범위 92 ~ 112
    iq 출렁임(sd 6~12 mA)은 게인과 무관하게 남는다 -> 한 바퀴에 한 번 걸리는 실제
    부하 토크를 루프가 iq 로 맞받는 것이고, 게인이 높을수록 같은 토크를 더 작은 속도
    오차로 낸다. 15 Hz 정지 구간에서도 노이즈 문제 없음(rpm sd 0.4, iq sd 0.8 mA).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
2026-10-10 data: 속도 계단 응답 15 Hz — 출렁임 sd 26~32 -> 5~8 rpm
    평균 100.0 / 199.9 / -149.5 / 0.0 rpm, sd 4.6 / 7.9 / 7.5 / 0.3 rpm.
    계단 직후 첫 100 ms 평균이 117 / 255 / -163 rpm 으로 지령을 넘는다 — 오버슈트가
    있다는 뜻이지만 100 ms 평균으로는 모양을 못 본다(다음에 ms 단위 기록).
    200 rpm 계단 첫 100 ms 에 전압 포화 10%, -150 rpm 첫 100 ms 에 7%.
2026-10-10 p1: 비동기 UART 송신 + 계단 응답 1 ms 기록, 속도 브레이크 데이터
    브레이크 테스트(150 rpm, 15 Hz): 잠깐 누르면 iq 가 120 mA 까지 올라 0.1 s 안에
    속도 복구. 꽉 잡은 5.5 s 동안 rpm 0, iq 150.0 mA(한계) 고정, id ±1 mA.
    1.6 s 한계에 붙어 있다 놓았을 때 다음 100 ms 평균 210 rpm 후 0.2 s 안에 150 —
    anti-windup 이 없었다면 적분기가 수 A 어치 쌓여 전압 한계 속도까지 튀었을 것.
    문제 발견: 송신이 블로킹이라 100 ms 마다 로그 한 줄(약 70 B, 6 ms) 동안 제어
    루프가 멈췄다. 첫 100 ms 만 1940 Hz, 이후 1810 Hz 인 것이 그 흔적.
    -> bsp: 2 KB 송신 큐 + USART2 TXE 인터럽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
2026-10-10 log: 2026-10-10 속도 루프 — 눌러도 속도를 지킨다 (p1 완료)
    - log: 설계(J·Kt 로 게인), 5 Hz 첫 계단 응답의 한 바퀴 출렁임, 대역폭 5/10/15 Hz
    비교(sd 52 -> 12 -> 5 rpm), 브레이크 테스트(꽉 잡으면 iq 150.0 mA 한계, 놓으면
    0.2 s 복귀, anti-windup 확인), 1 ms 계단 응답(상승 11~15 ms, 오버슈트 13~54%),
    블로킹 로그가 루프를 6 ms 씩 멈추던 결함
    - notes: 속도 루프 설계 — 대역폭 분리, Kp = J·ωc/Kt, 외란 억제, PI 영점이 만드는
    13.5% 오버슈트와 실측 차이의 후보, 조건부 적분
    - 로드맵 6단계 완료 처리, 7단계(위치 루프) 진행 중으로. p1 체크리스트·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
2026-10-10 p1: 위치 루프 — 위치 P + 사다리꼴 궤적 + 속도·가속 피드포워드
    캐스케이드 맨 바깥: ω_ref = v_ff + Kp_pos·(θ_궤적 - θ), iq_ff = J·a_ff/Kt.
    Kp_pos = 2π·4 = 25 /s (속도 루프 15 Hz 의 약 1/4), 속도 지령 ±200 rpm 제한
    궤적: 최고 120 rpm, 가속도 300 rad/s² (90도 이동 167 ms, 450도 667 ms)
    위치는 엔코더 언랩 누적(멀티턴), 0 = 실행 시작 위치. 오차 90도 초과면 정지.
    속도 PI 의 적분기가 있어 일정한 부하에서도 정지 위치 오차는 0 으로 간다.
    cl_step_t.is_speed -> mode (전류/속도/위치), raw_step(궤적 없는 계단) 추가.
    고해상도 기록을 칸 크기(g_cap_dt)를 바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
2026-10-10 data: 위치 루프 첫 이동 — 멀티턴 정확, 정지 부근 끈적임(stick-slip)
    1 s 이후 평균 위치: 0 유지 -0.02 / +90 -> 90.05 / +450 -> 450.02 / 복귀 0.24 /
    +30 계단 30.07 / 0 -> 0.18 deg. 정지 중 오차 ±0.5 deg, iq 약 5 mA.
    궤적 추종 중 최대 오차 3~8 deg (등속 중 한 바퀴 부하로 ±2~3 deg 출렁임).
    +30 계단(궤적 없음)은 위치 P + 속도 제한 덕에 튀지 않았지만 19 deg 에서 약 50 ms
    멈췄다 다시 감 — 0~20 deg 부근에 끈적이는 구간. 복귀 이동 끝에서도 7.9 deg 에
    멈췄다가 적분기가 쌓인 뒤 풀리며 -4.2 deg 까지 넘어가고 거기서 또 200 ms 멈춤.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
2026-10-10 log: 2026-10-10 위치 루프 — 같은 자리로 돌아오고, 밀면 버티고 놓으면 돌아온다
    - 위치 유지 테스트(h): 약 12번, 최대 42 deg 밀었다 놓음. 밀린 채로는 iq 가
    0.1~0.2 s 에 한계 150 mA 까지 오름. 놓으면 0.3~0.4 s 에 ±2 deg, 약 1 s 에 ±0.2 deg.
    반대로 넘어가는 양 8~19 deg 가 밀린 거리와 무관 -> 한계에 붙어 저장된 속도 적분기 몫.
    - log: 설계, 멀티턴 이동, 궤적 없는 계단이 얌전했던 이유와 궤적의 진짜 가치,
    stick-slip, 놓았을 때 넘어가는 양
    - notes: 위치 루프와 궤적 — 1차 응답, 안쪽 적분기가 만드는 정지 오차 0, 사다리꼴 궤적·
    피드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
2026-10-10 log: 위치 루프 — 손으로 확인한 뻑뻑한 구간(약 20도) 기록
    PWM 끈 뒤 손으로 여러 번 돌려서야 느낄 정도의 약 20도 구간. 제어기는 같은
    끈적임을 iq 18 mA(약 1.5 mN·m) 차이로 또렷하게 봤다. 다음 숙제로 모터 자체로
    각도별 마찰 지도를 그리는 실험을 적어둠.
2026-10-10 notes: 로드맵에 전체 지도(큰 단원 Ⅰ~Ⅲ) 추가 — Ⅰ 모터 관절 하나 완료
